m24h/esp2400/running/frontface-install1.jpg

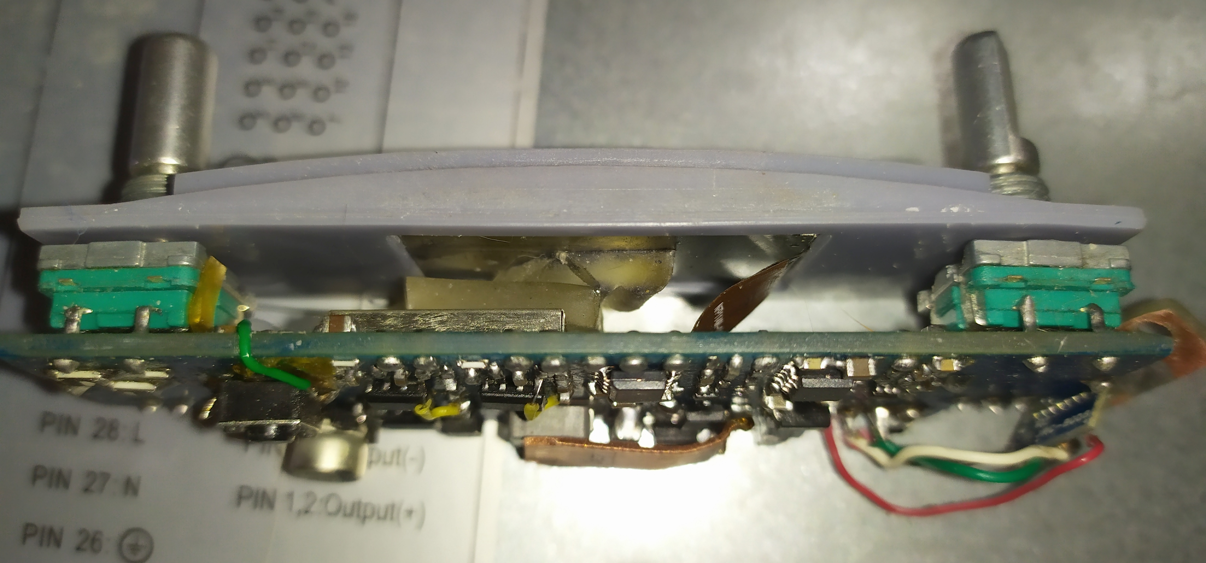
running/frontface-install1.jpg
