m24h/esp2400/hardware/discharge_output/discharge_pcb.png

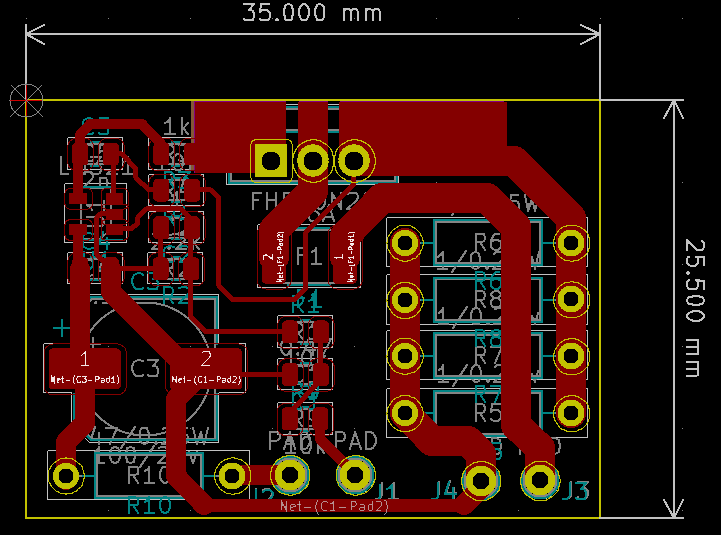
hardware/discharge_output/discharge_pcb.png
