m24h/esp2400/hardware/discharge_output/discharge_sch.png

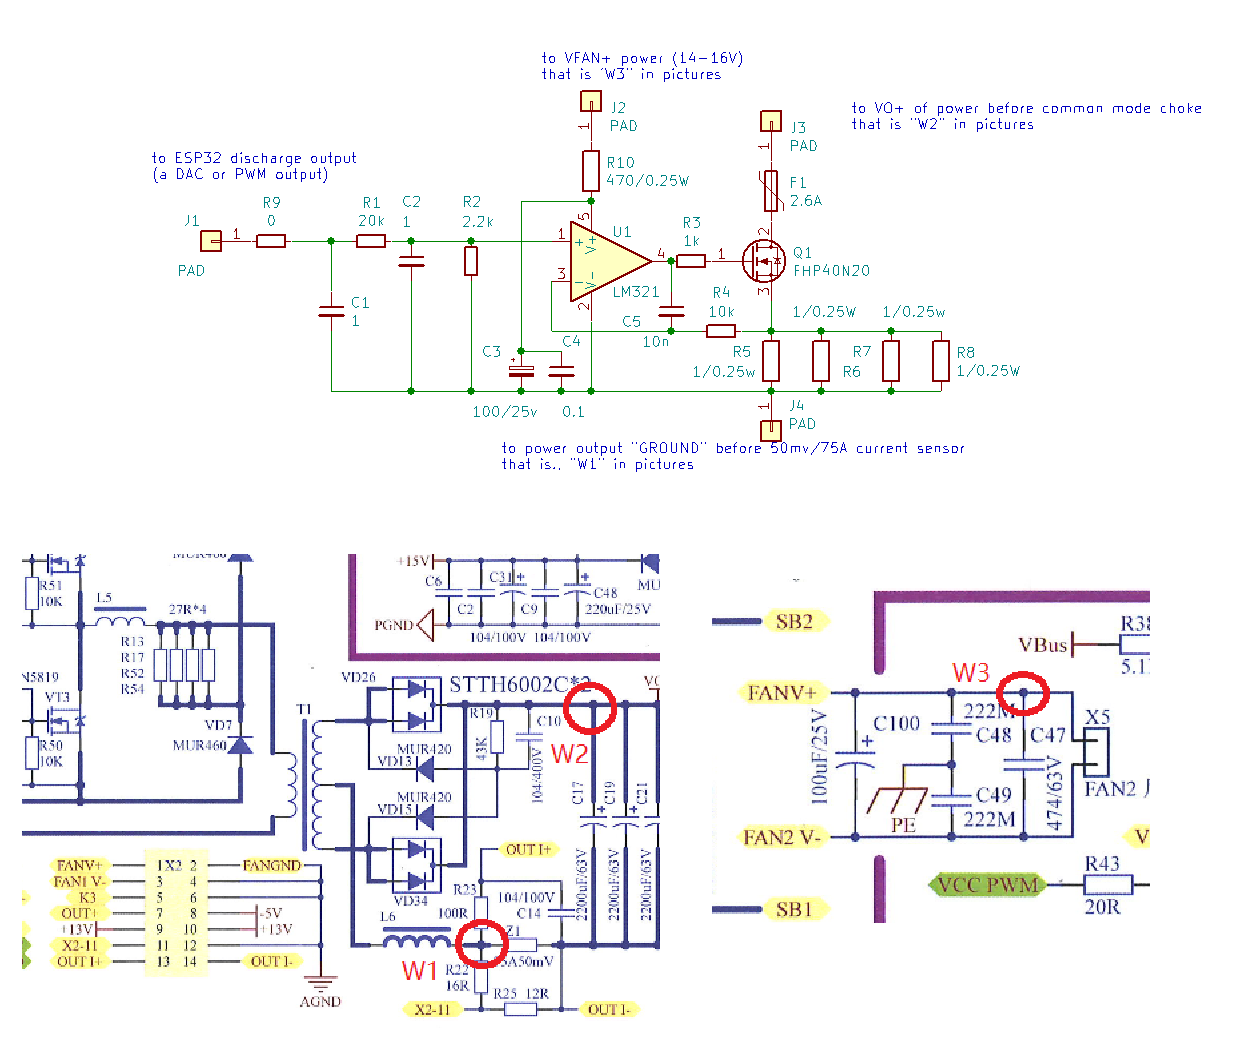
hardware/discharge_output/discharge_sch.png
