m24h/esp2400/hardware/esp2400_output/esp2400_pcb_B.png

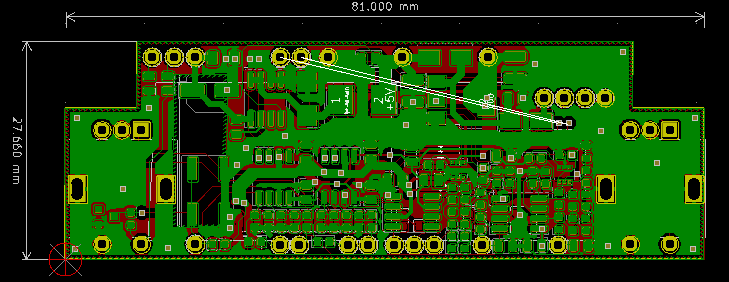
hardware/esp2400_output/esp2400_pcb_B.png
