m24h/esp2400/hardware/esp2400_output/esp2400_sch.png

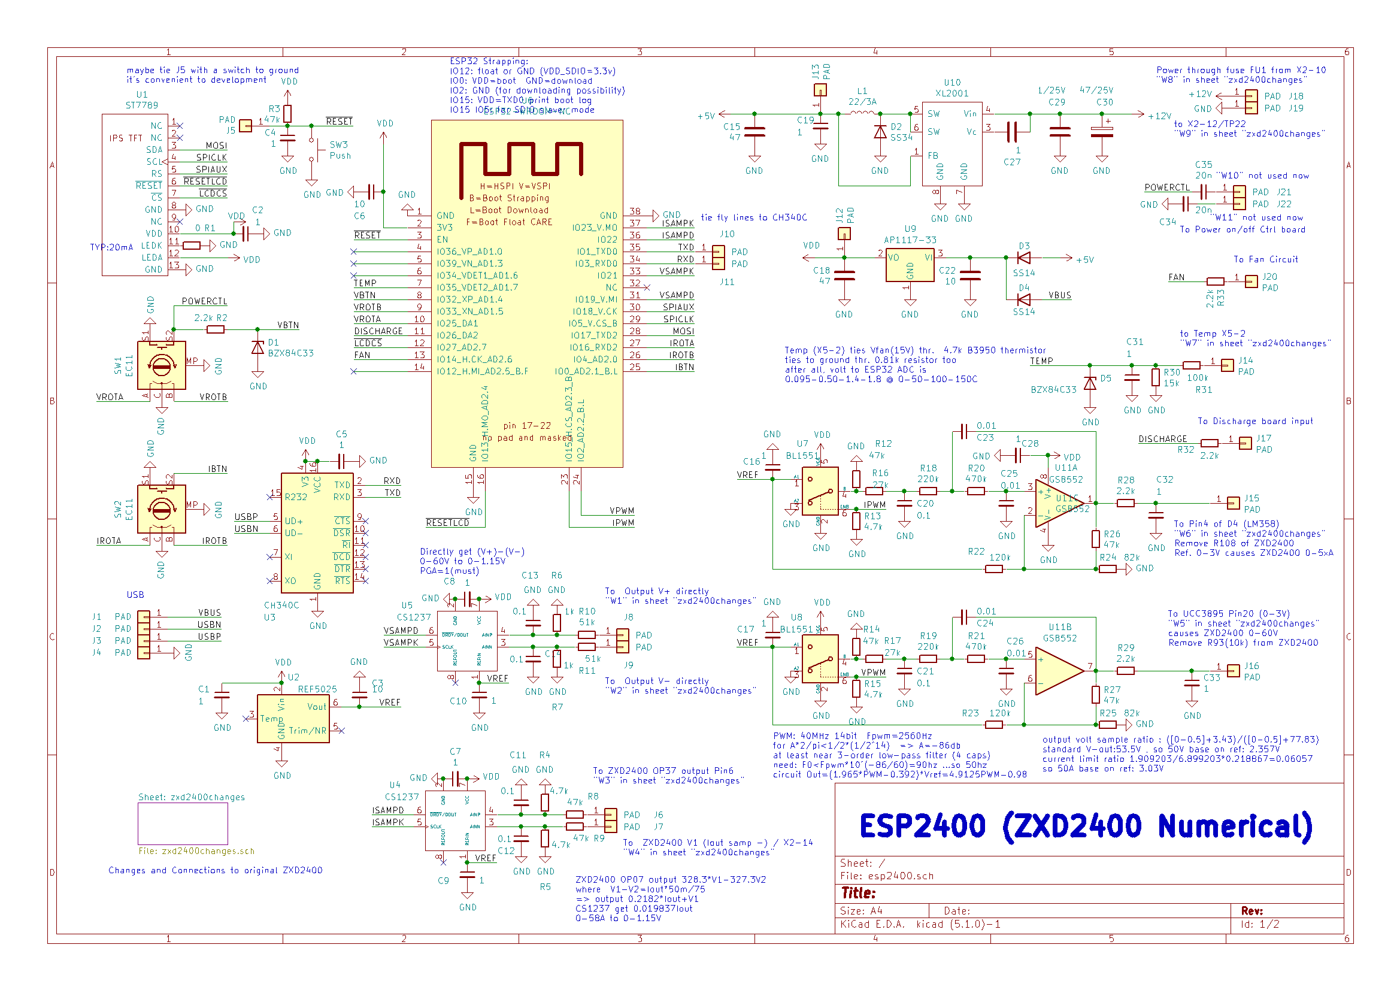
hardware/esp2400_output/esp2400_sch.png
