m24h/esp2400/hardware/fan_output/fan_pcb.png

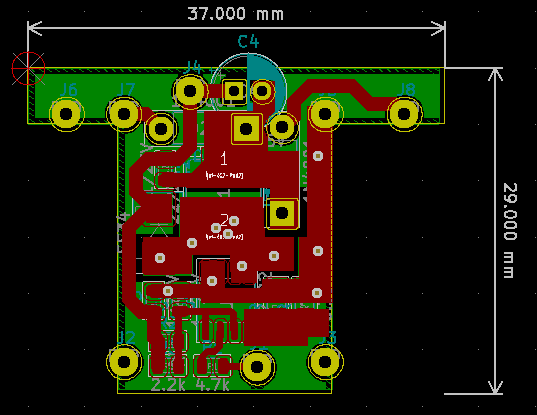
hardware/fan_output/fan_pcb.png
