m24h/esp2400/hardware/fan_output/fan_sch.png

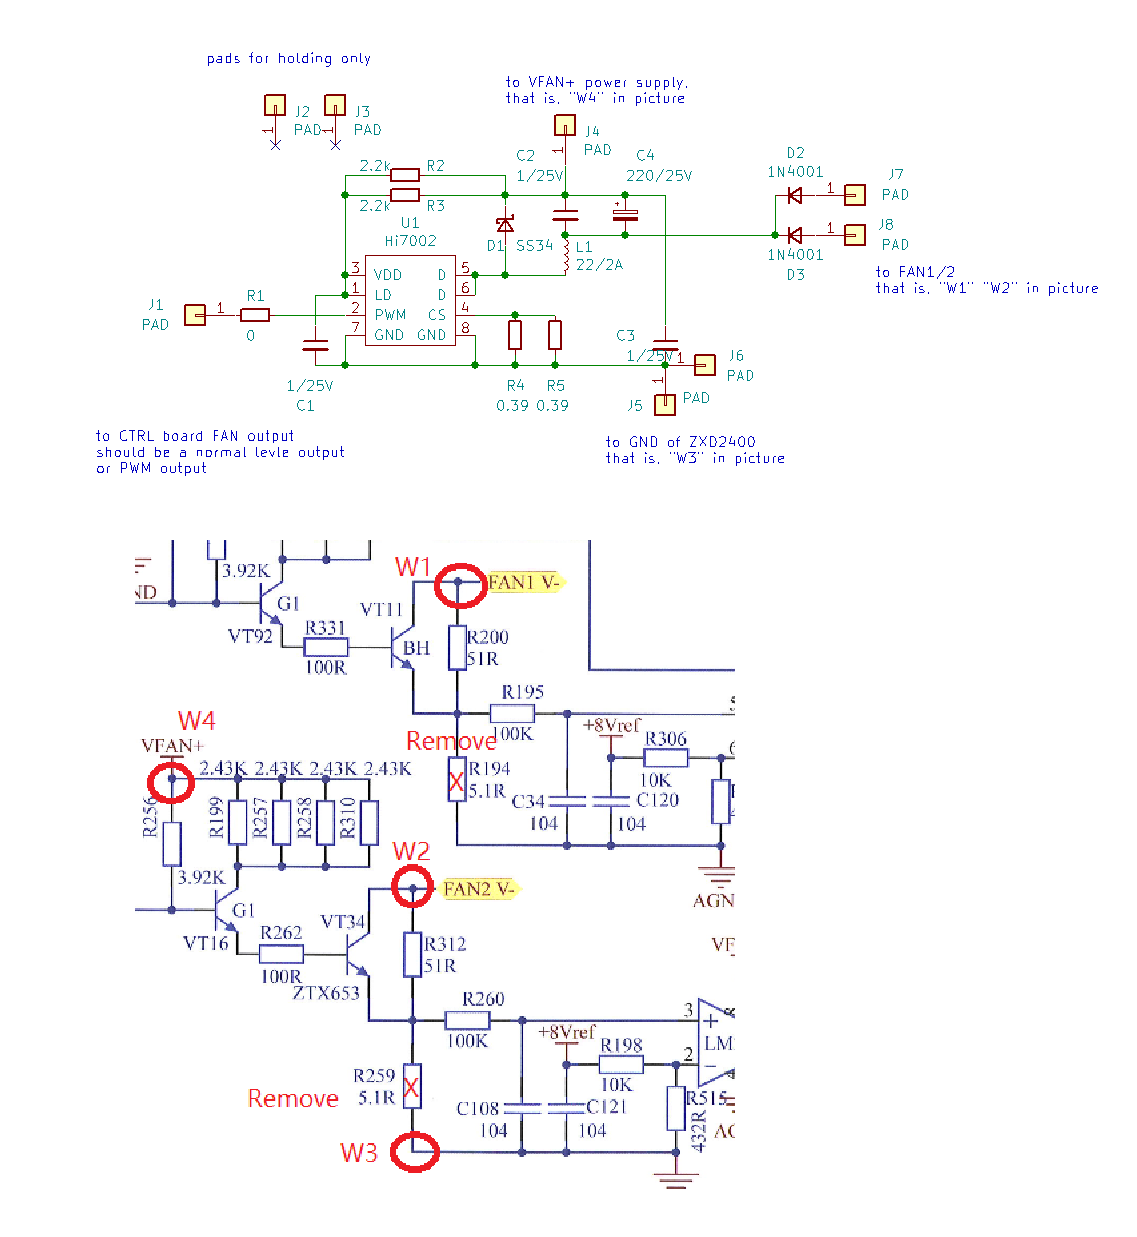
hardware/fan_output/fan_sch.png
