m24h/esp2400/running/discharge-connect.png

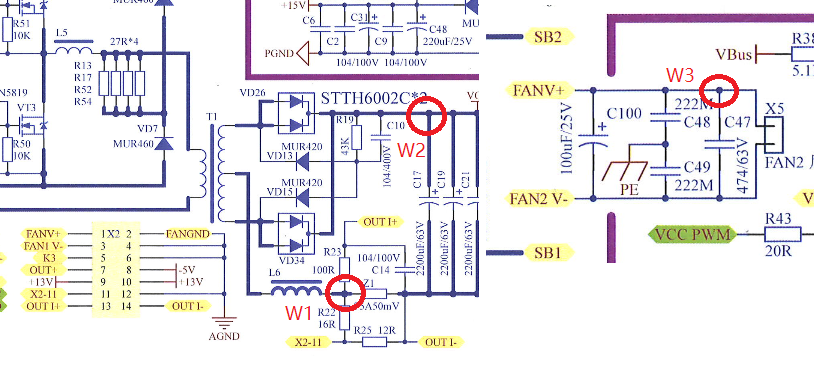
running/discharge-connect.png
