m24h/esp2400/running/drifting in 2 hours.jpg

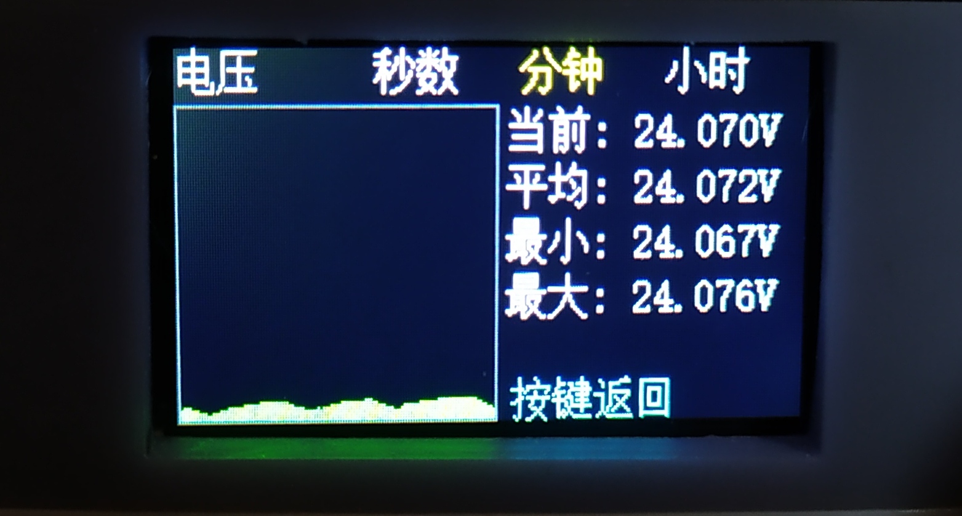
running/drifting in 2 hours.jpg
