m24h/esp2400/running/esp2400-connect.png

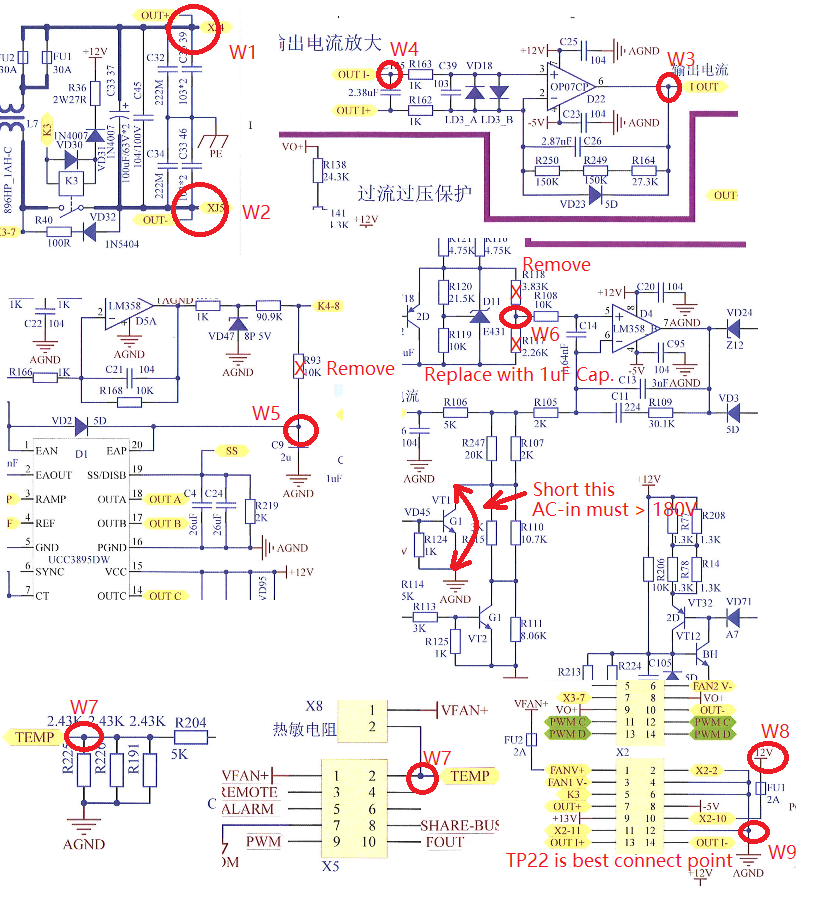
running/esp2400-connect.png
