m24h/esp2400/running/fan and discharge board.jpg

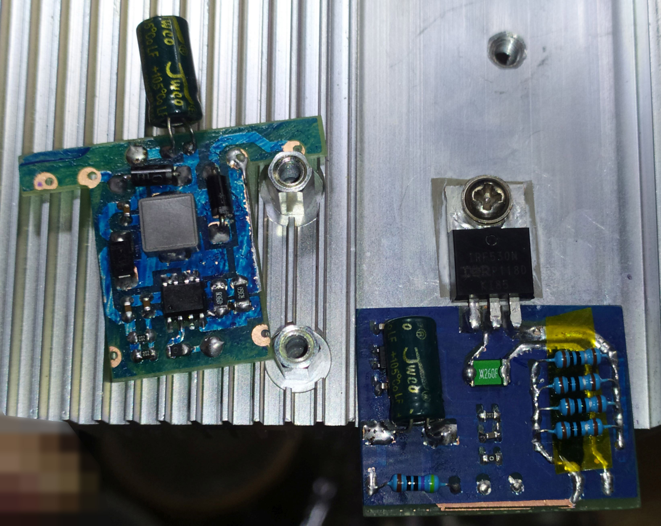
running/fan and discharge board.jpg
