m24h/esp2400/running/fan-connect.png

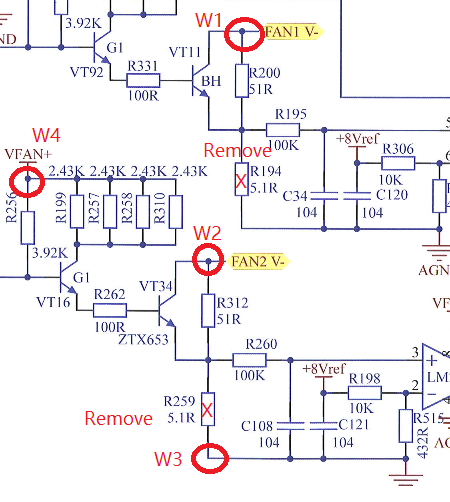
running/fan-connect.png
