m24h/esp2400/running/Mask NC Pin of ESP32.jpg

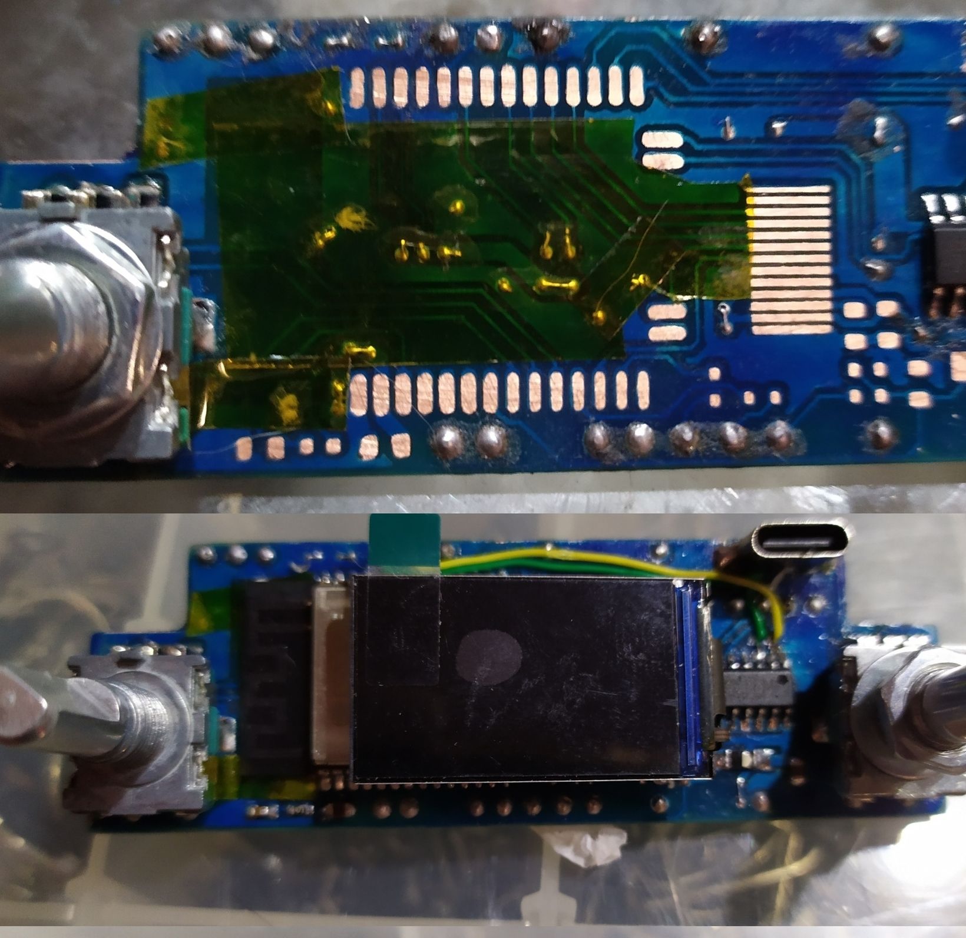
running/Mask NC Pin of ESP32.jpg
