m24h/esp2400/running/modify1.jpg

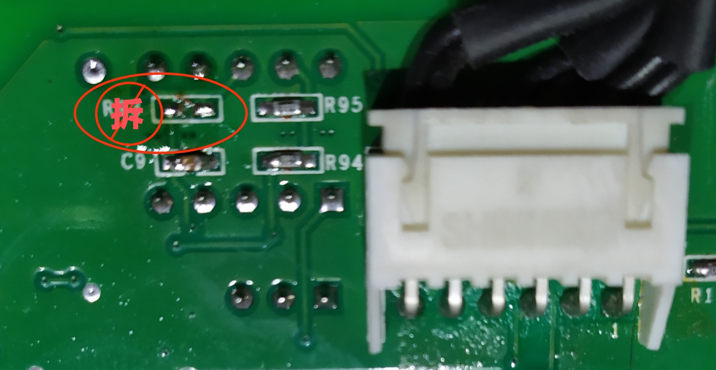
running/modify1.jpg
