m24h/esp2400/running/modify2.jpg

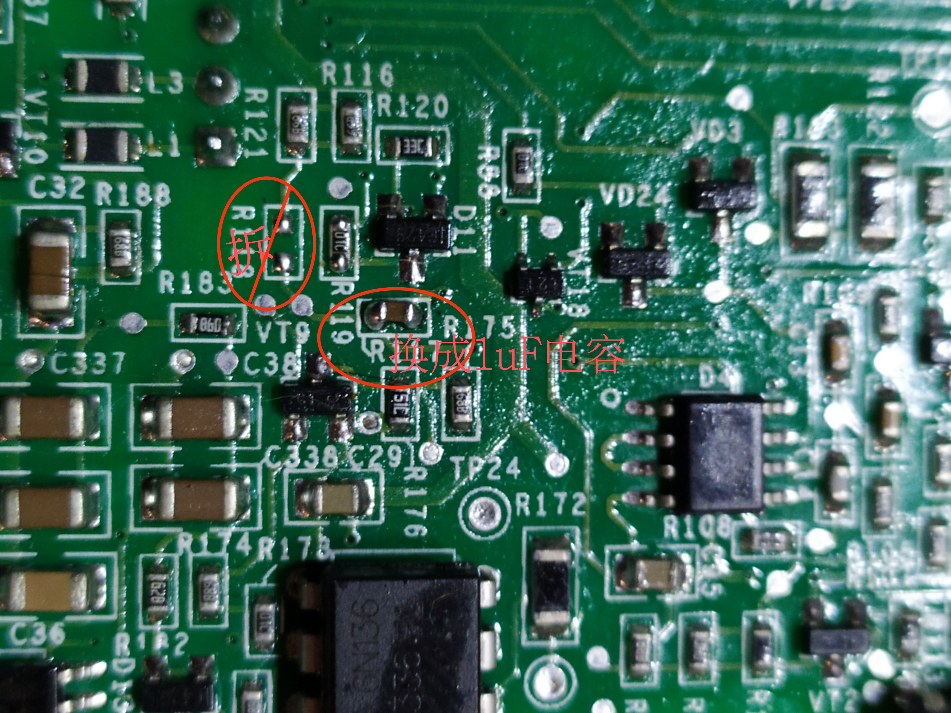
running/modify2.jpg
