m24h/esp2400/running/modify3.jpg

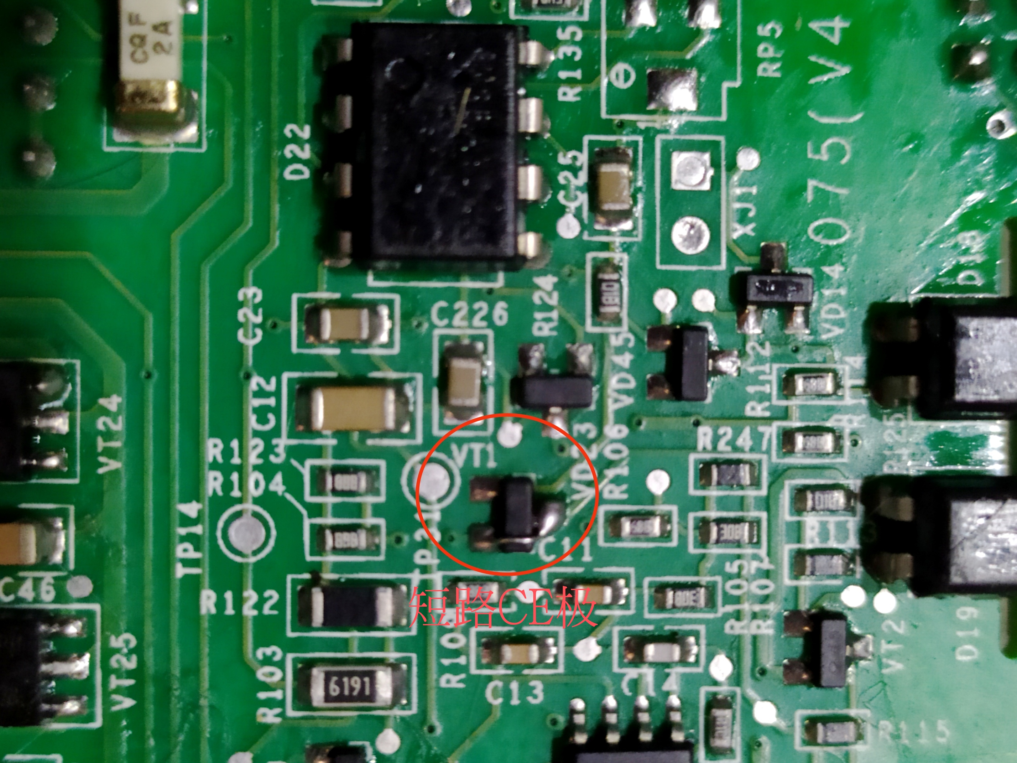
running/modify3.jpg
