m24h/esp2400/running/output 1.1V.jpg

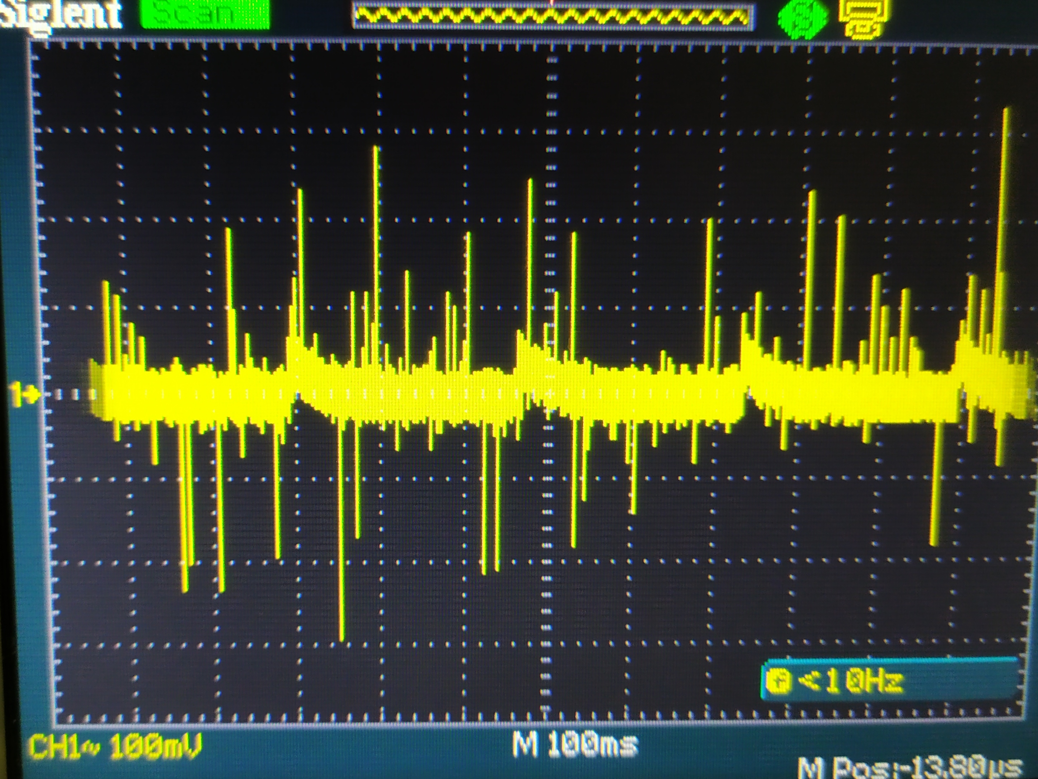
running/output 1.1V.jpg
