m24h/esp2400/running/output greater than 5V.jpg

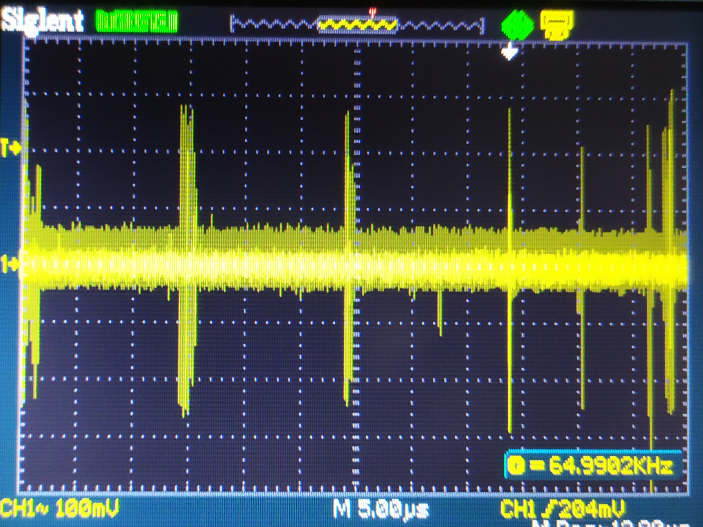
running/output greater than 5V.jpg
