m24h/esp2400/parts/backface.png

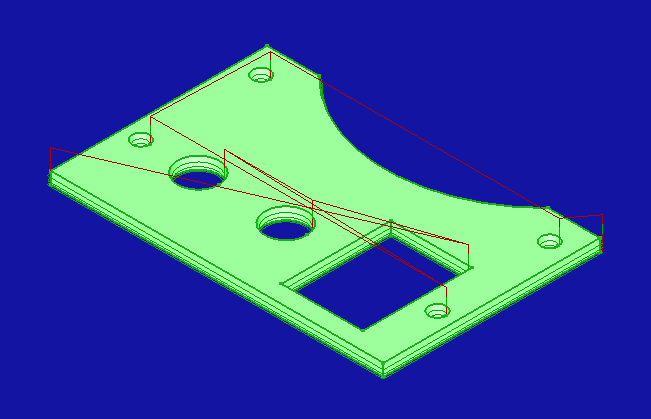
parts/backface.png
