m24h/esp2400/parts/face.png

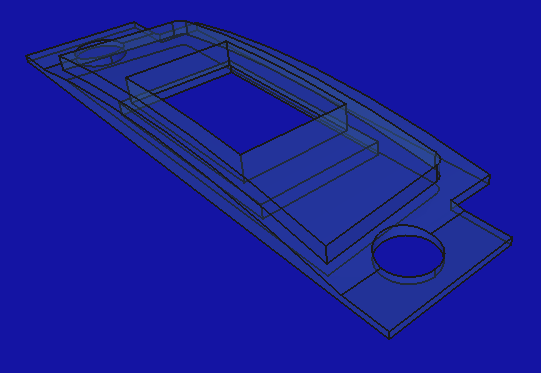
parts/face.png
