m24h/esp2400/parts/Mezzanine.png

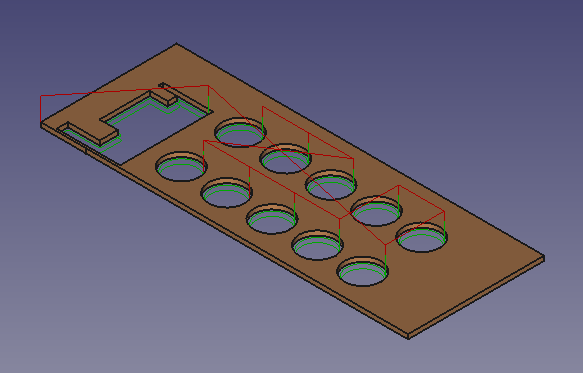
parts/Mezzanine.png
