m24h/esp2400/parts/face.FCStd

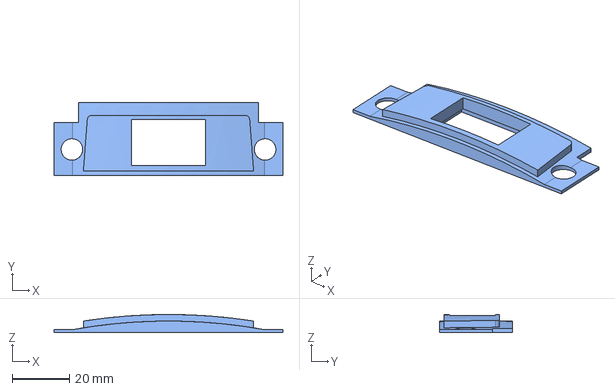
[picture p24: CAD file, 2022-01-13]
parts/face.FCStd
80.0 x 25.5 x 6.30 mm
