m24h/esp2400/parts/backface.FCStd

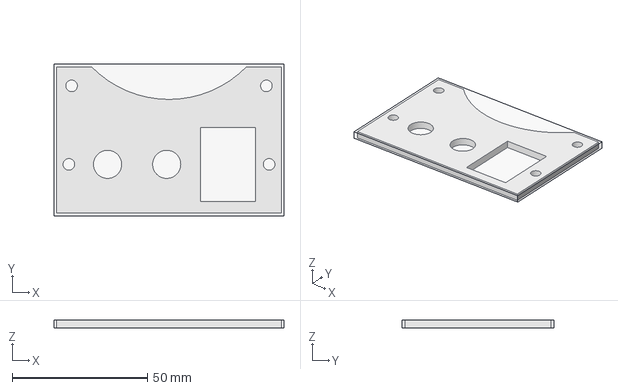
[picture p25: CAD file, 2022-01-13]
parts/backface.FCStd
85.0 x 56.0 x 3.00 mm
Model-Body
Stock
