m24h/esp2400/parts/Mezzanine.FCStd

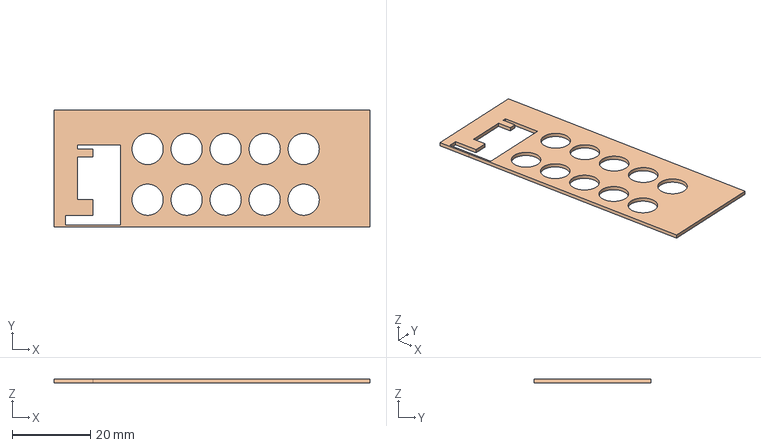
[picture p26: CAD file, 2022-01-13]
parts/Mezzanine.FCStd
81.0 x 30.0 x 1.00 mm
