m24h/esp2400/(list of files, cad)

Other CAD files:
parts/face.stl
