m24h/esp2400/running/backface-install2.jpg

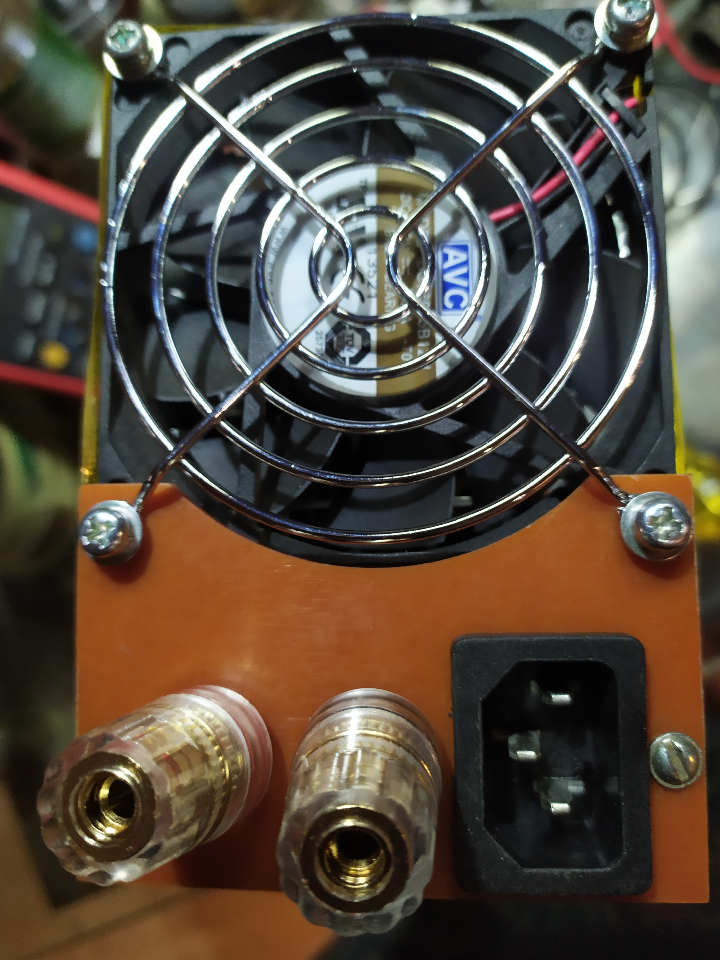
running/backface-install2.jpg
