m24h/esp2400/running/discharge-install.jpg

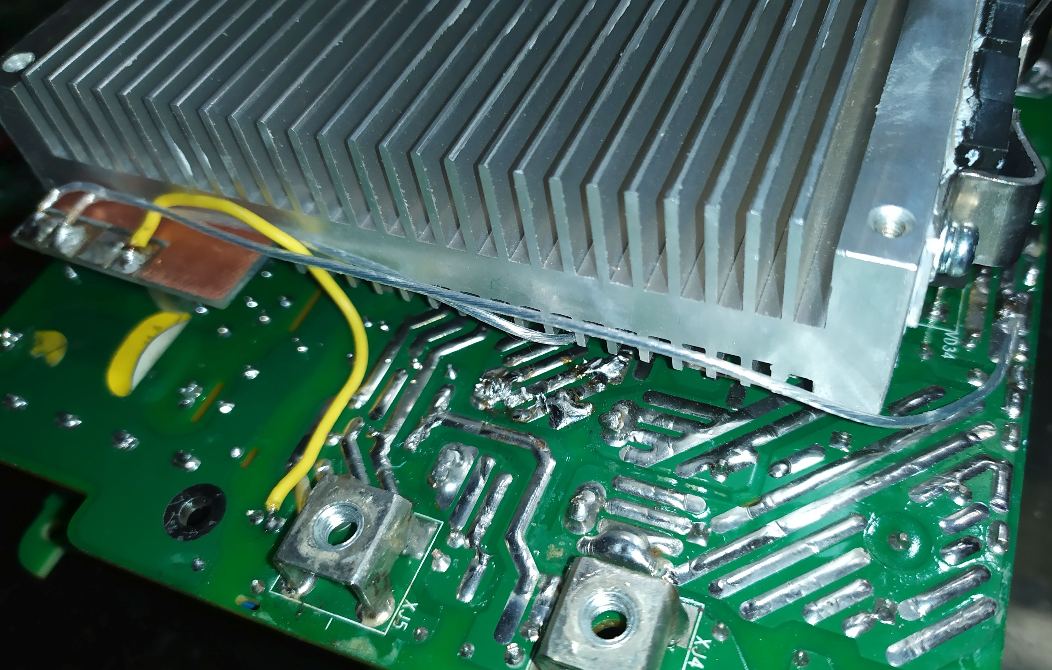
running/discharge-install.jpg
