m24h/esp2400/running/esp2400-install1.jpg

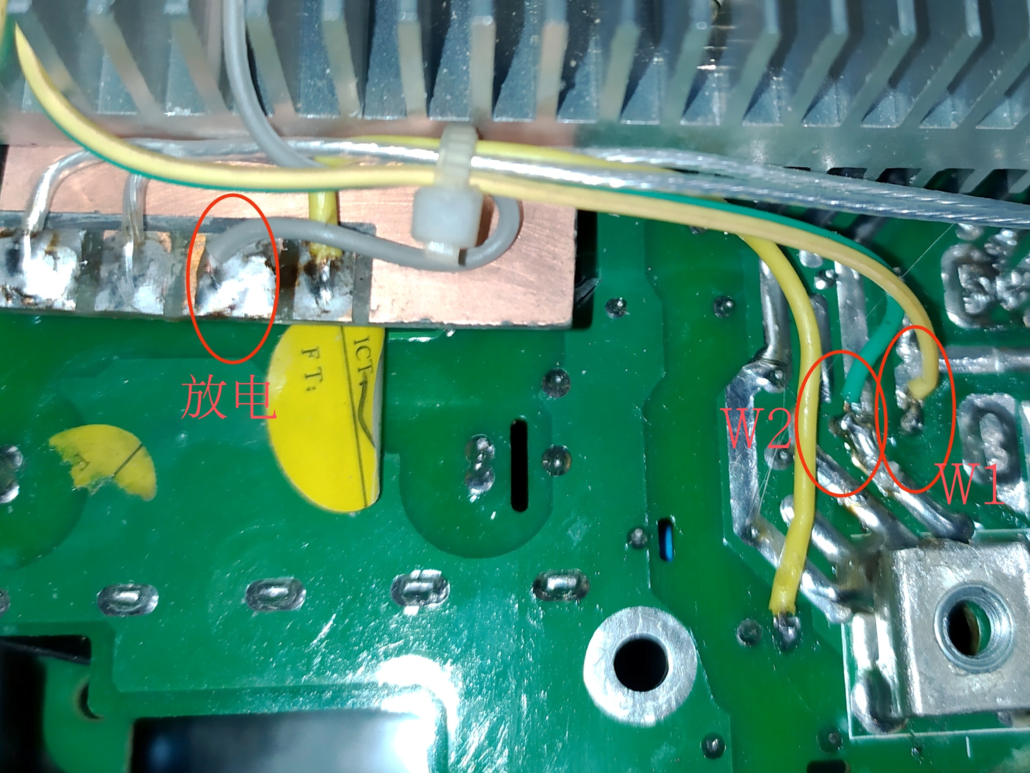
running/esp2400-install1.jpg
