m24h/esp2400/running/esp2400-install4.jpg

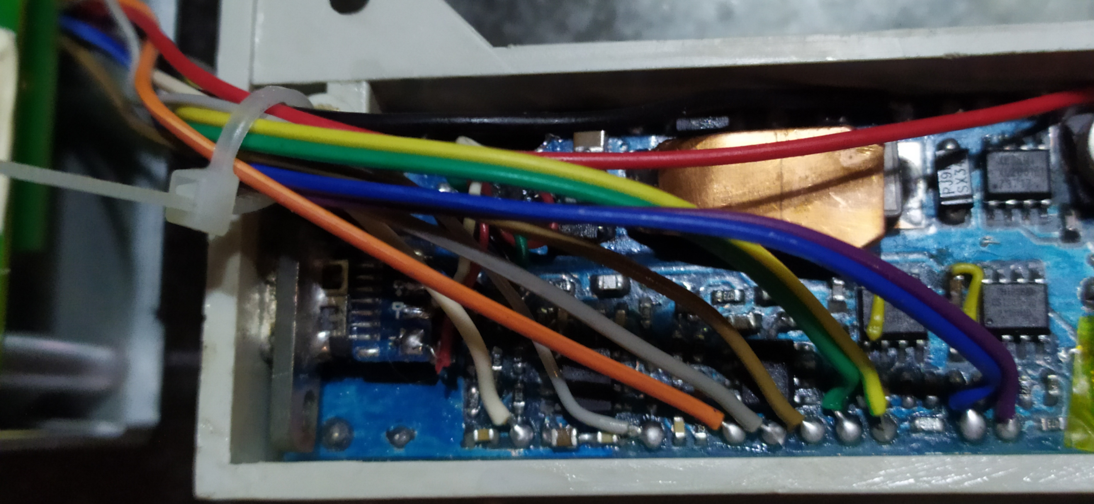
running/esp2400-install4.jpg
