m24h/esp2400/running/fan-install.jpg

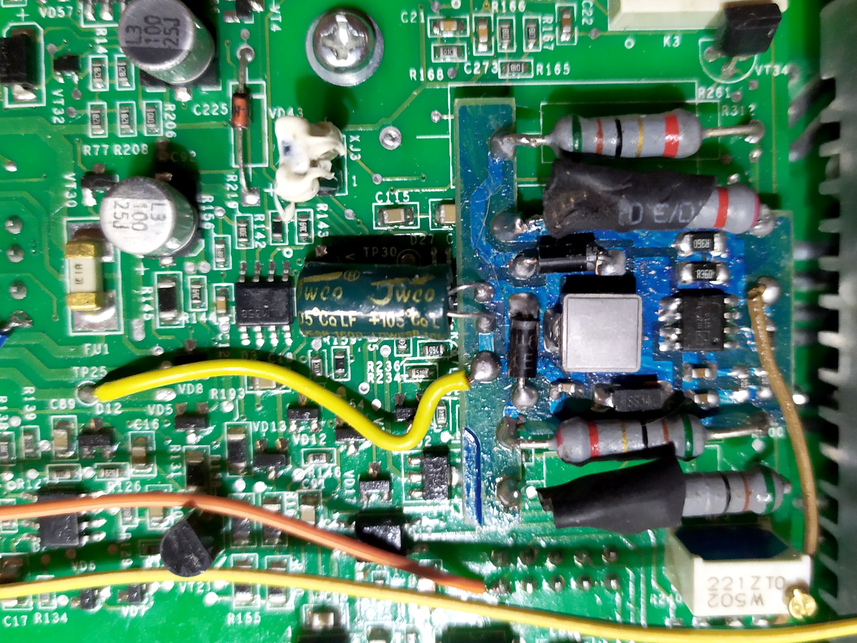
running/fan-install.jpg
