m24h/esp2400/running/frontface-install2.jpg

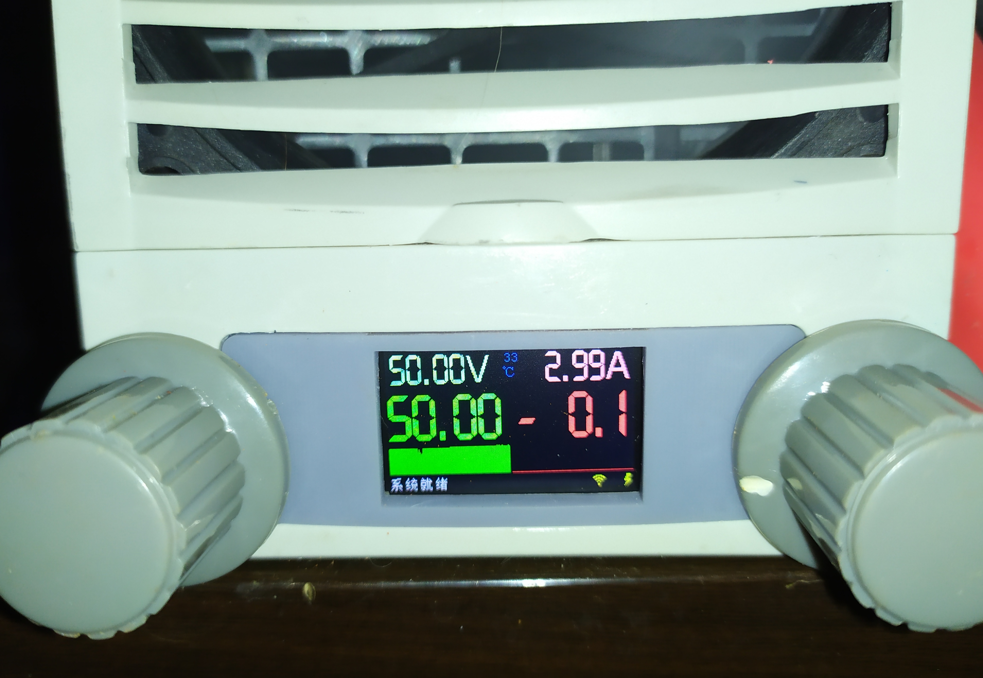
running/frontface-install2.jpg
