m24h/esp2400/running/mezzanine-install.jpg

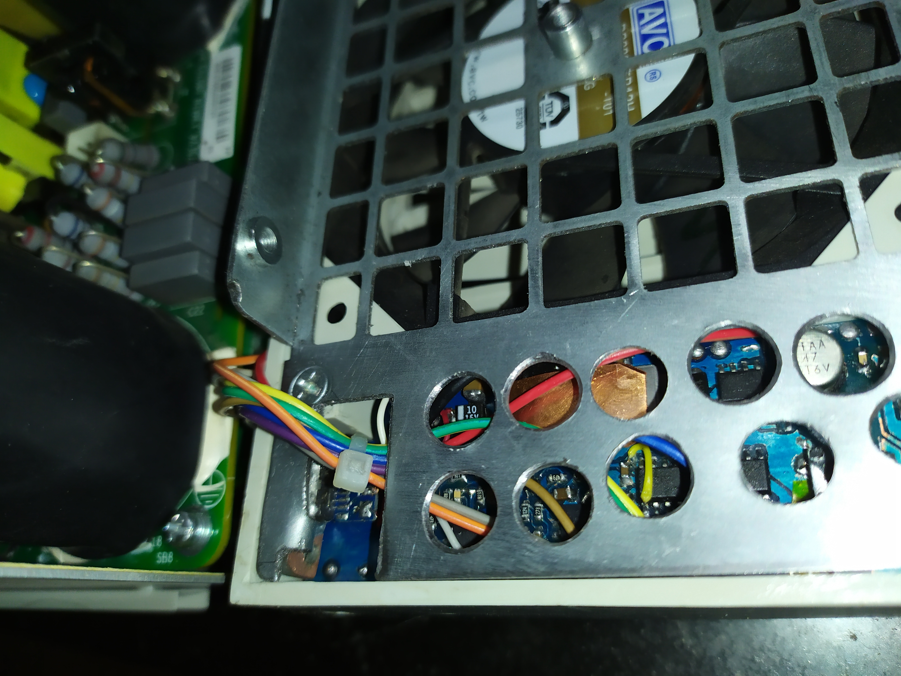
running/mezzanine-install.jpg
