m24h/esp2400/hardware/discharge_output/discharge-F_Cu.pdf

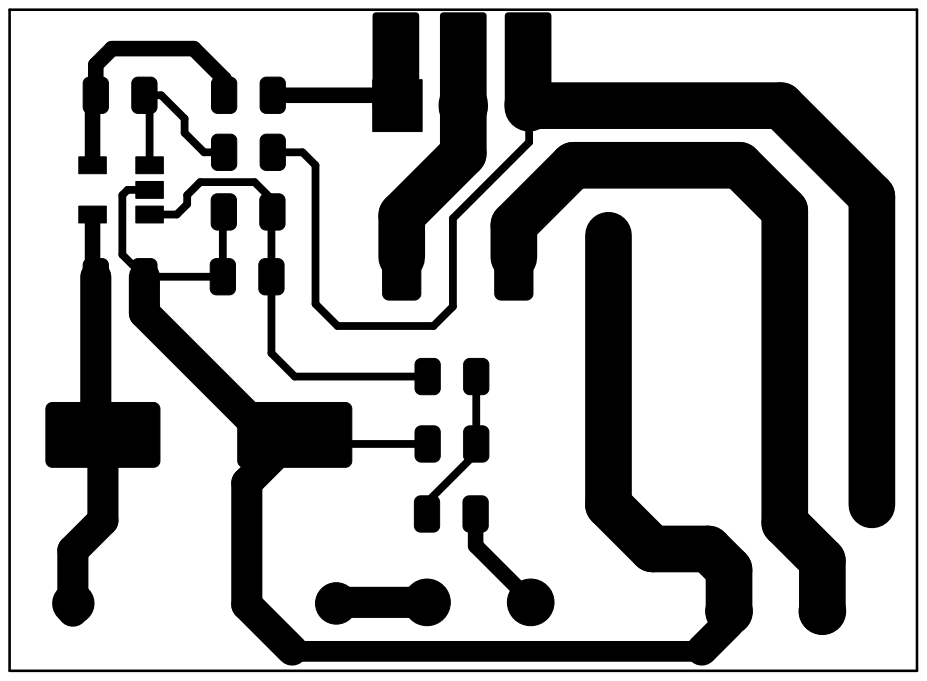
[picture p35: page 1]
