m24h/esp2400/hardware/discharge_output/discharge-F_Mask.pdf

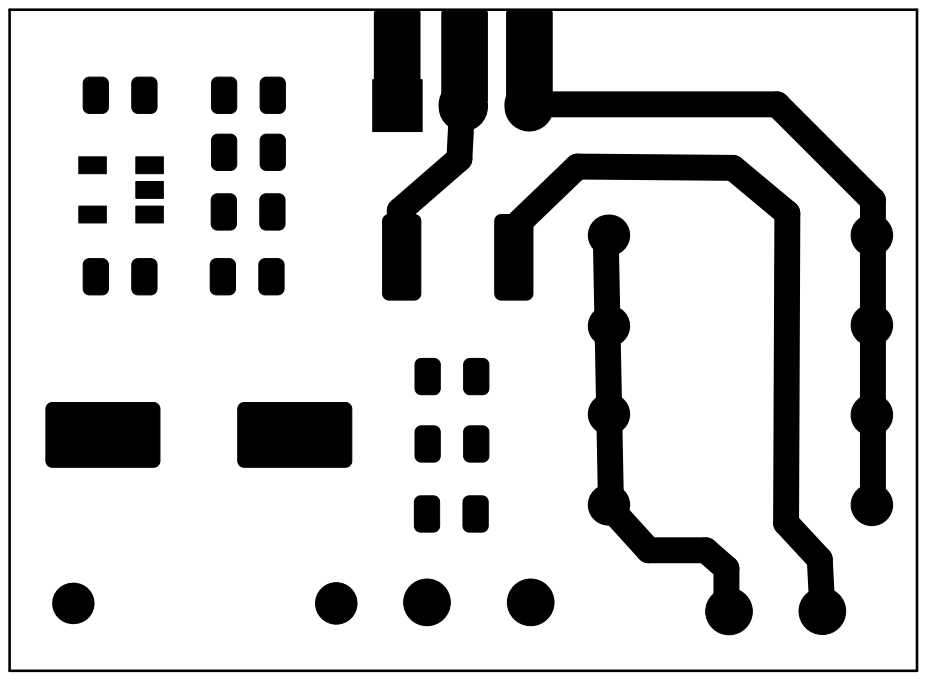
[picture p36: page 1]
