m24h/esp2400/hardware/esp2400_output/esp2400-B_Cu.pdf

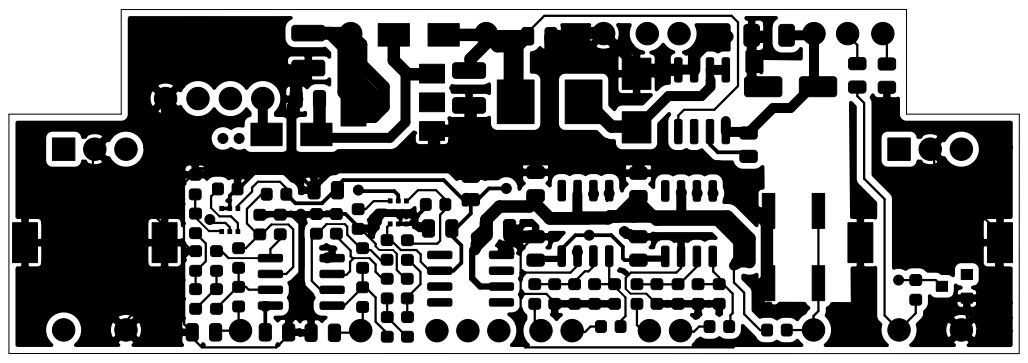
[picture p37: page 1]
