m24h/esp2400/hardware/esp2400_output/esp2400-B_Mask.pdf

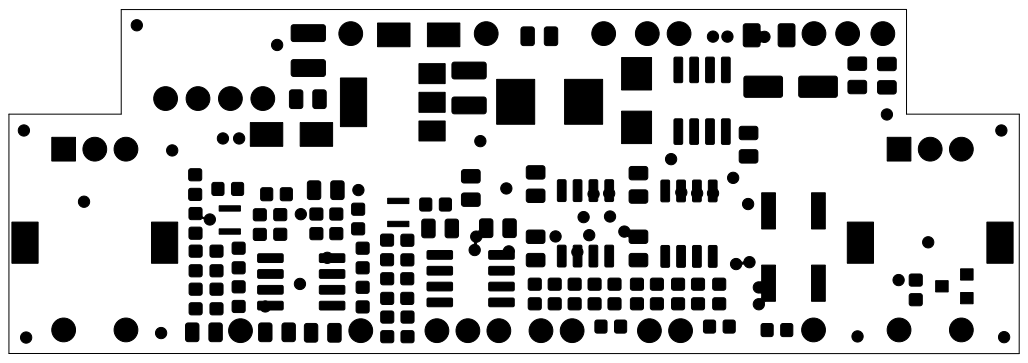
[picture p38: page 1]
