m24h/esp2400/hardware/esp2400_output/esp2400-F_Cu.pdf

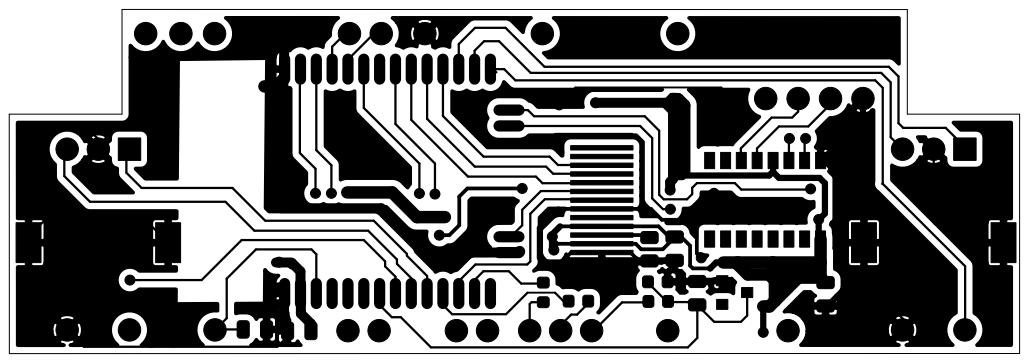
[picture p39: page 1]
