m24h/esp2400/hardware/esp2400_output/esp2400-F_Mask.pdf

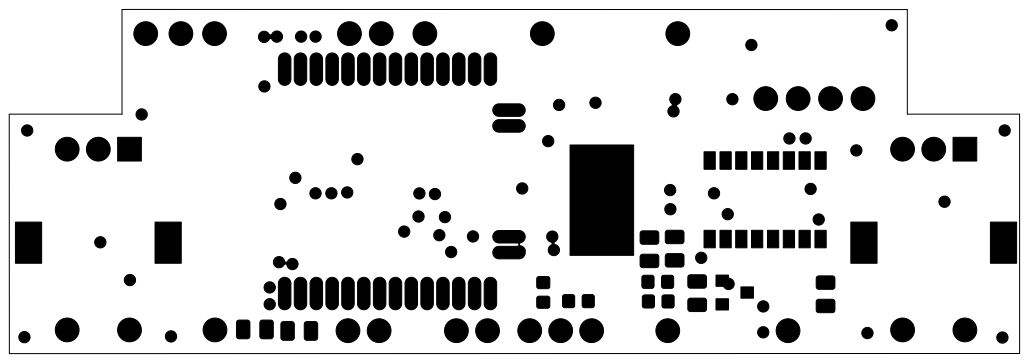
[picture p40: page 1]
