m24h/esp2400/hardware/fan_output/fan-B_Cu.pdf

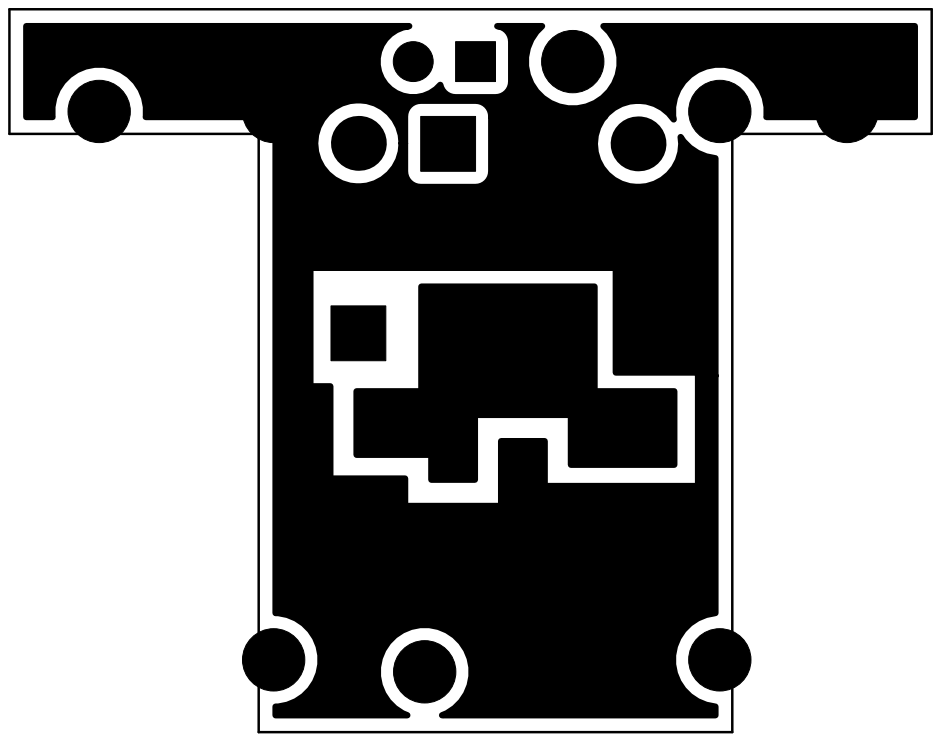
[picture p41: page 1]
