m24h/esp2400/hardware/fan_output/fan-B_Mask.pdf

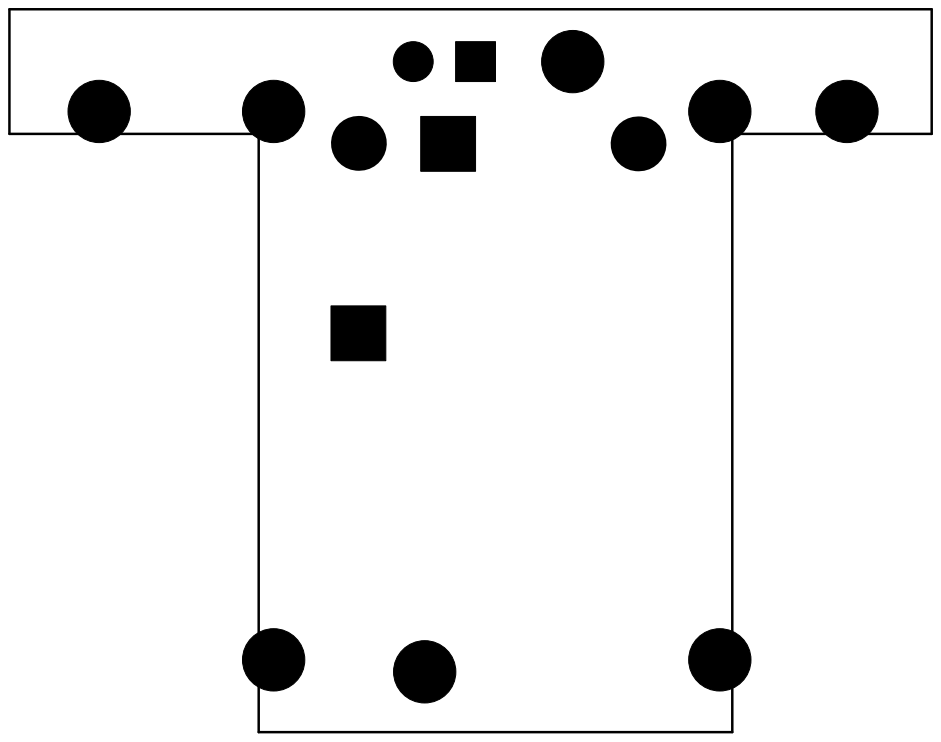
[picture p42: page 1]
