m24h/esp2400/hardware/fan_output/fan-F_Cu.pdf

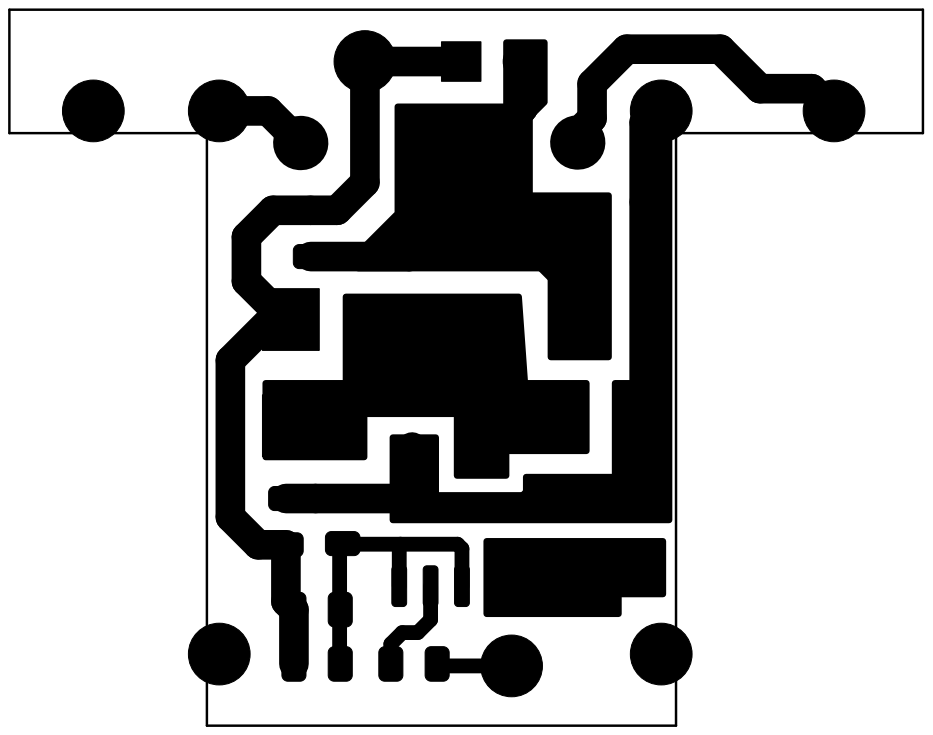
[picture p43: page 1]
