m24h/esp2400/hardware/fan_output/fan-F_Mask.pdf

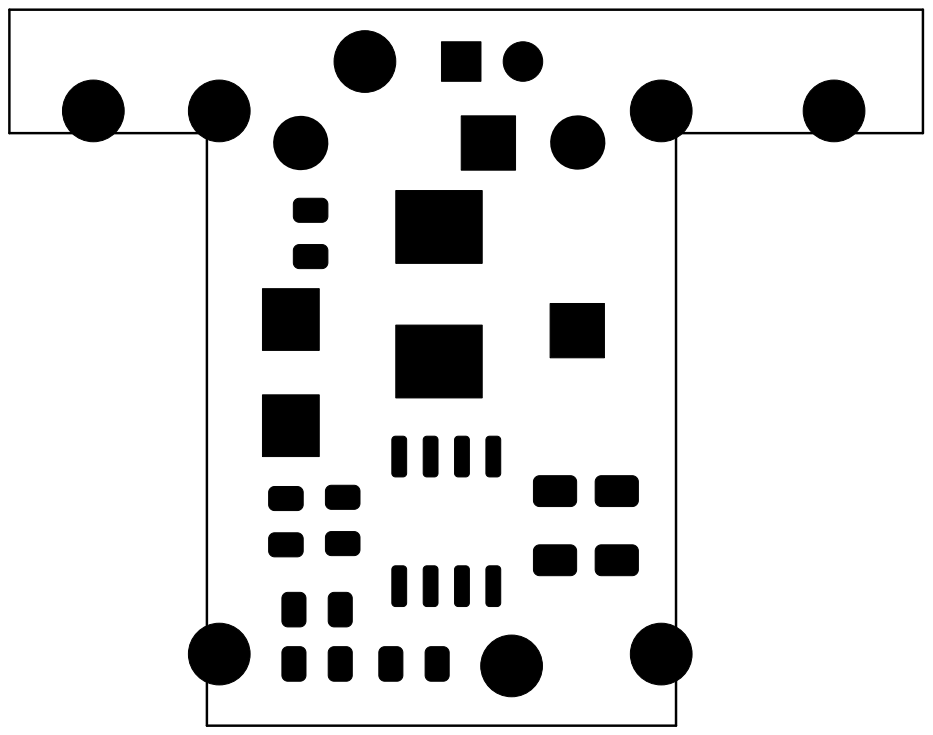
[picture p44: page 1]
