m24h/esp2400/hardware/discharge.kicad_pcb

## KiCad design hardware/discharge.kicad_pcb (2022-01-13)

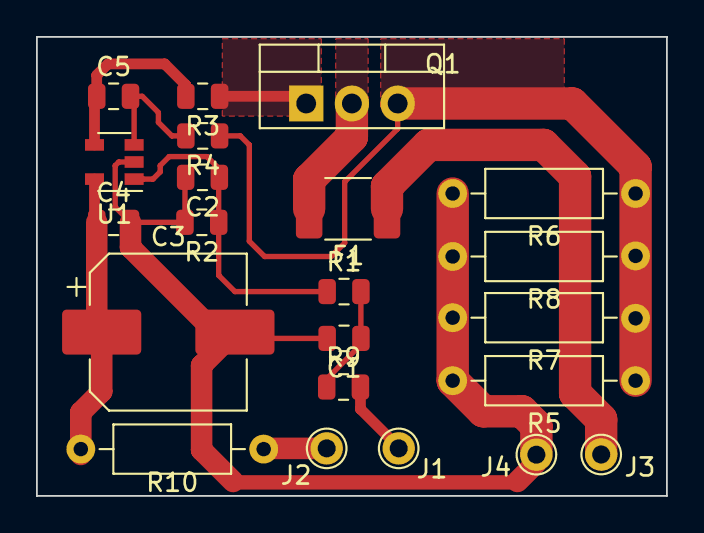
[picture p45: board discharge.kicad_pcb from above]

Board: 2 copper layers, 35.0 x 25.5 mm, 22 parts (0 on the bottom side), 12 nets.

Parts:
C1: 0.47; C_0805_2012Metric
C2: 1; C_0805_2012Metric
C3: 100/25v; CP_Elec_8x10.5
C4: 0.1; C_0805_2012Metric
C5: 2n; C_0805_2012Metric
F1: 2.6A; Fuse_1812_4532Metric_Castellated
J1, J2, J3, J4: PAD; Pad
Q1: FHP40N20; TO-220-3_Vertical
R1, R4, R9: 10k; R_0805_2012Metric
R2: 2.2k; R_0805_2012Metric
R3: 1k; R_0805_2012Metric
R5, R7: 1/0.25w; R_Axial_DIN0207_L6.3mm_D2.5mm_P10.16mm_Horizontal
R6, R8: 1/0.25W; R_Axial_DIN0207_L6.3mm_D2.5mm_P10.16mm_Horizontal
R10: 47/0.25W; R_Axial_DIN0207_L6.3mm_D2.5mm_P10.16mm_Horizontal
U1: LM321; SOT-23-5

Connections:
unnamed: C1.1, R1.2, R9.1
unnamed: C1.2, C2.2, C3.2, C4.2, J4.1, R2.2, R5.2, R6.2, R7.2, R8.2, U1.2
unnamed: C2.1, R1.1, R2.1, U1.1
unnamed: C3.1, C4.1, R10.2, U1.5
unnamed: C5.1, R3.2, U1.4
unnamed: C5.2, R4.2, U1.3
unnamed: F1.1, J3.1
unnamed: F1.2, Q1.2
unnamed: J1.1, R9.2
unnamed: J2.1, R10.1
unnamed: Q1.1, R3.1
unnamed: Q1.3, R4.1, R5.1, R6.1, R7.1, R8.1
