m24h/esp2400/hardware/esp2400.kicad_pcb

## KiCad design hardware/esp2400.kicad_pcb (2022-01-13)

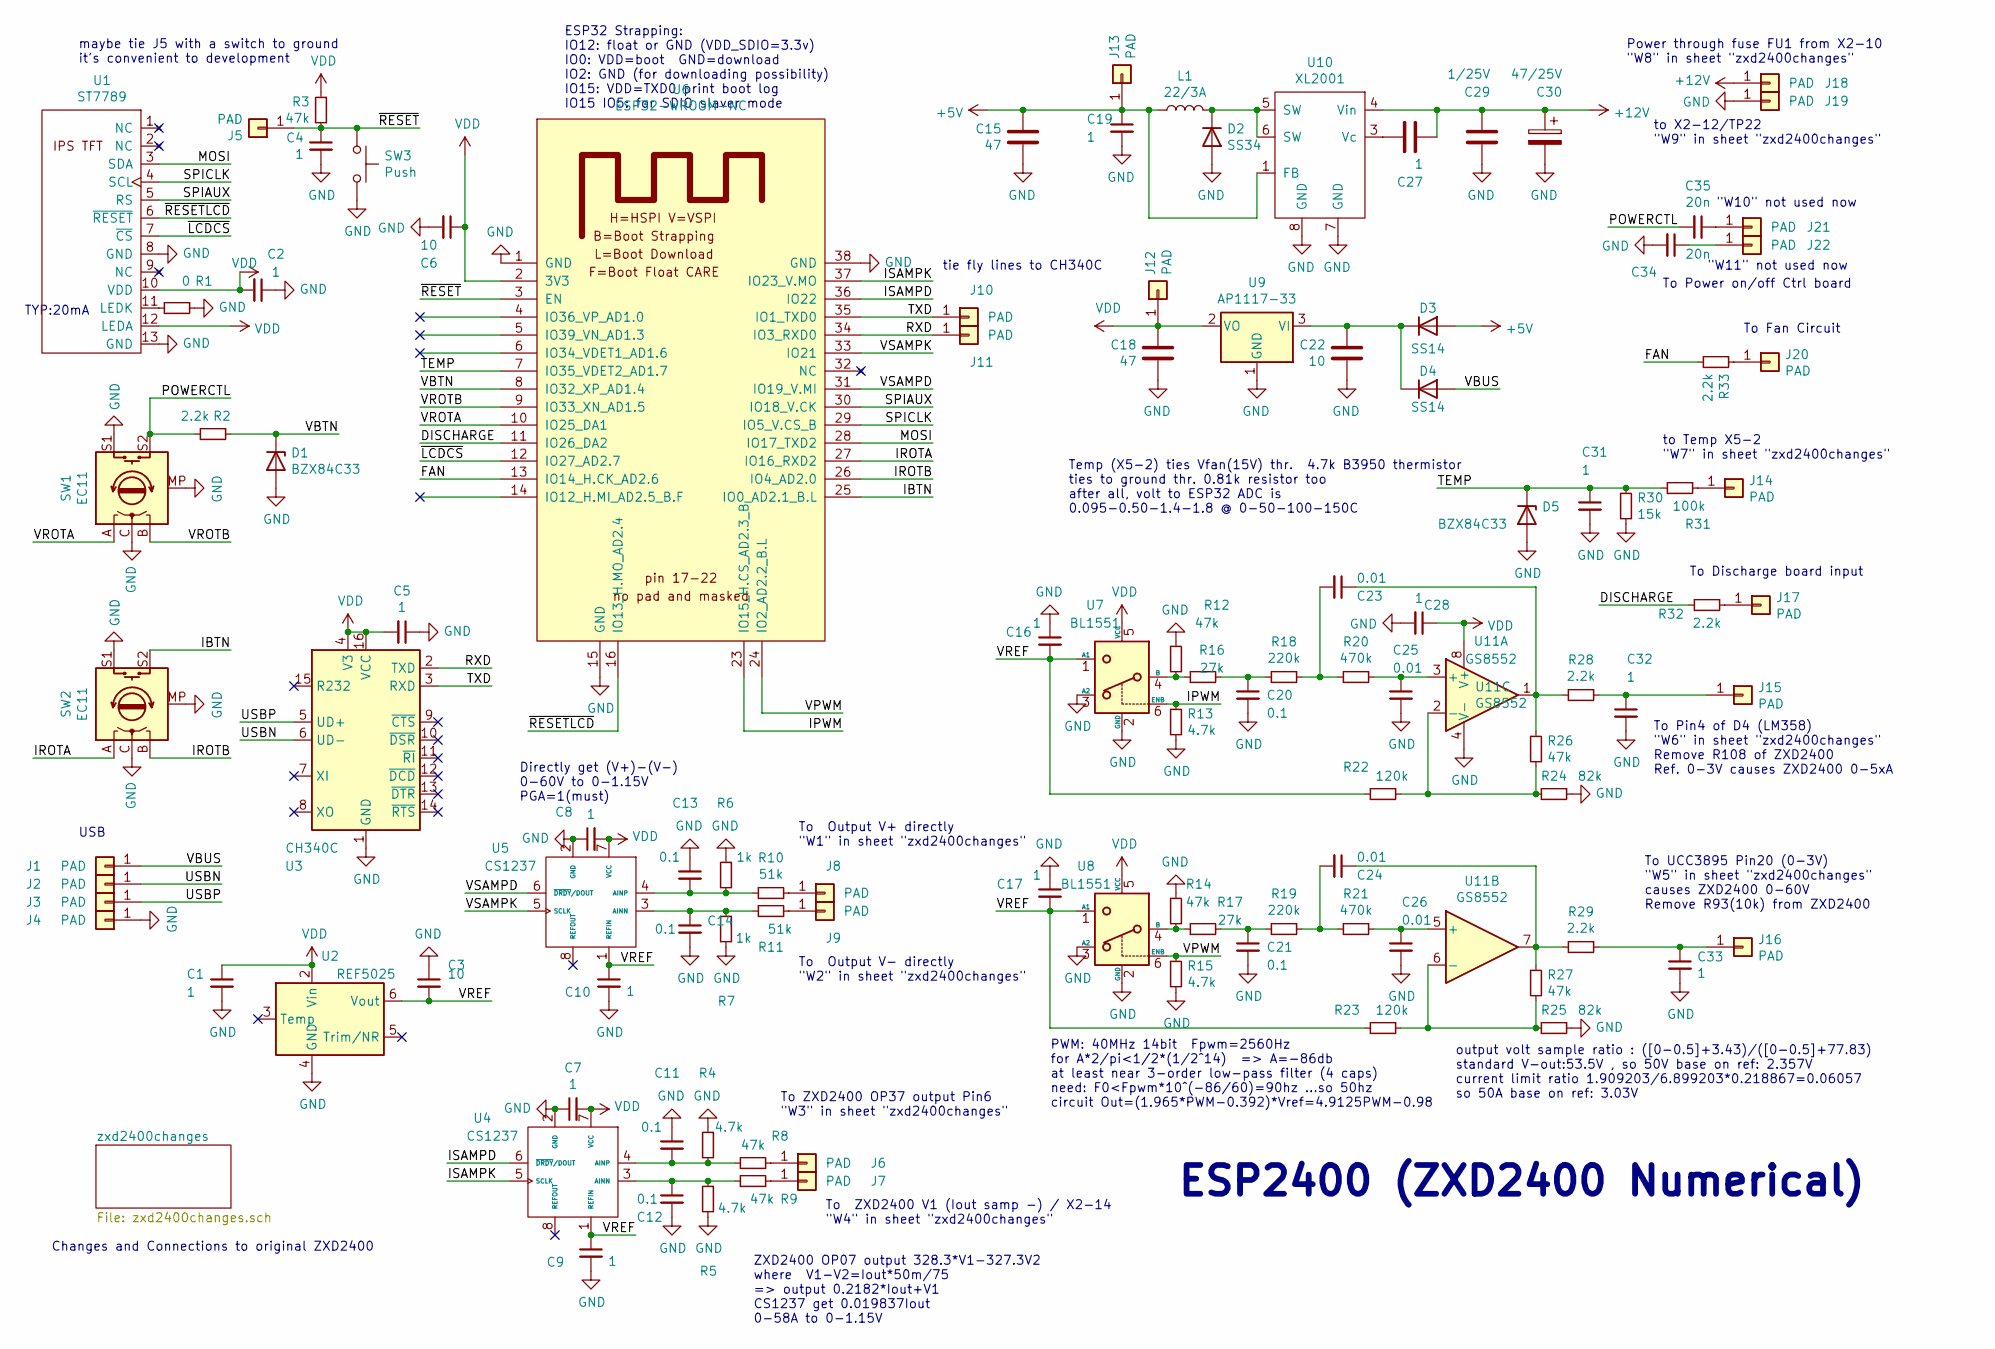
[picture p46: schematic esp2400.sch]

Parts:
C1, C2, C4, C5, C7, C8, C9, C10, C16, C17, C19, C27, C28, C31, C32, C33: 1; C_0805_2012Metric
C3, C6, C22: 10; C_0805_2012Metric
C11, C12, C13, C14, C20, C21: 0.1; C_0603_1608Metric
C15, C18: 47; C_1210_3225Metric
C23, C24, C25, C26: 0.01; C_0603_1608Metric
C29: 1/25V; C_1206_3216Metric
C30: 47/25V; CP_Elec_5x5.9
C34, C35: 20n; C_0805_2012Metric
D1, D5: BZX84C33; D_SOT-23_ANK
D2: SS34; D_SMB
D3, D4: SS14; D_SMA
J1, J2, J3, J4, J5, J6, J7, J8, J9, J10, J11, J12, J13, J14, J15, J16, J17, J18, J19, J20, J21, J22: PAD; Pad
L1: 22/3A; L_Bourns_SRP7028A_7.3x6.6mm
R1: 0; R_0805_2012Metric
R2, R28, R29, R32, R33: 2.2k; R_0603_1608Metric
R3, R8, R9, R12, R14, R26, R27: 47k; R_0603_1608Metric
R4, R5, R13, R15: 4.7k; R_0603_1608Metric
R6, R7: 1k; R_0603_1608Metric
R10, R11: 51k; R_0603_1608Metric
R16, R17: 27k; R_0603_1608Metric
R18, R19: 220k; R_0603_1608Metric
R20, R21: 470k; R_0603_1608Metric
R22, R23: 120k; R_0603_1608Metric
R24, R25: 82k; R_0603_1608Metric
R30: 15k; R_0603_1608Metric
R31: 100k; R_0603_1608Metric
SW1, SW2: EC11; RotaryEncoder_Alps_EC11E-Switch_Vertical_H20mm
SW3: Push; SW_Push_1P1T_NO_CK_KSC6xxJ
U1: ST7789; 1.14LCD
U2: REF5025; SOIC-8_3.9x4.9mm_P1.27mm
U3: CH340C; SOP-16_4.4x10.4mm_P1.27mm
U4, U5: CS1237; SOP-8_3.9x4.9mm_P1.27mm
U6: ESP32-WROOM-NC
U7, U8: BL1551; SC70-6
U9: AP1117-33; SOT-223-3_TabPin2
U10: XL2001; SOIC-8_3.9x4.9mm_P1.27mm
U11: GS8552; SOIC-8_3.9x4.9mm_P1.27mm

Connections:
+5V: C15.1, C19.1, D3.2 (A), J13.1, L1.2, U10.1 (FB)
+12V: C27.2, C29.1, C30.1, J18.1, U10.4 (Vin)
/DISCHARGE: R32.2, U6.11 (IO26_DA2)
/FAN: R33.2, U6.13 (IO14_H.CK_AD2.6)
/IBTN: SW2.S2, U6.25 (IO0_AD2.1_B.L)
/IPWM: R13.1, U6.23 (IO15_H.CS_AD2.3_B), U7.6 (ENB)
/IROTA: SW2.A, U6.27 (IO16_RXD2)
/IROTB: SW2.B, U6.26 (IO4_AD2.0)
/ISAMPD: U4.6 (~DRDY~/DOUT), U6.36 (IO22)
/ISAMPK: U4.5 (SCLK), U6.37 (IO23_V.MO)
/MOSI: U1.3 (SDA), U6.28 (IO17_TXD2)
/POWERCTL: C35.2, R2.2, SW1.S2
/RXD: J11.1, U3.2 (TXD), U6.34 (IO3_RXD0)
/SPIAUX: U1.5 (RS), U6.30 (IO18_V.CK)
/SPICLK: U1.4 (SCL), U6.29 (IO5_V.CS_B)
/TEMP: C31.1, D5.1 (K), R30.1, R31.2, U6.7 (IO35_VDET2_AD1.7)
/TXD: J10.1, U3.3 (RXD), U6.35 (IO1_TXD0)
/USBN: J2.1, U3.6 (UD-)
/USBP: J3.1, U3.5 (UD+)
/VBTN: D1.1 (K), R2.1, U6.8 (IO32_XP_AD1.4)
/VBUS: D4.2 (A), J1.1
/VPWM: R15.1, U6.24 (IO2_AD2.2_B.L), U8.6 (ENB)
/VREF: C3.2, C9.1, C10.1, C16.2, C17.2, R22.2, R23.2, U2.6 (Vout), U4.1 (REFIN), U5.1 (REFIN), U7.1 (A1), U8.1 (A1)
/VROTA: SW1.A, U6.10 (IO25_DA1)
/VROTB: SW1.B, U6.9 (IO33_XN_AD1.5)
/VSAMPD: U5.6 (~DRDY~/DOUT), U6.31 (IO19_V.MI)
/VSAMPK: U5.5 (SCLK), U6.33 (IO21)
/~LCDCS: U1.7 (~CS), U6.12 (IO27_AD2.7)
/~RESET: C4.1, J5.1, R3.2, SW3.1, U6.3 (EN)
/~RESETLCD: U1.6 (~RESET), U6.16 (IO13_H.MO_AD2.4)
GND: C1.2, C2.1, C3.1, C4.2, C5.1, C6.2, C7.1, C8.1, C9.2, C10.2, C11.1, C12.2, C13.1, C14.2, C15.2, C16.1, C17.1, C18.2, C19.2, C20.2, C21.2, C22.2, C25.2, C26.2, C28.2, C29.2, C30.2, C31.2, C32.2, C33.2, C34.2, D1.2 (A), D2.2 (A), D5.2 (A), J4.1, J19.1, R1.1, R4.1, R5.2, R6.1, R7.2, R12.1, R13.2, R14.1, R15.2, R24.1, R25.1, R30.2, SW1.C, SW1.MP, SW1.S1, SW2.C, SW2.MP, SW2.S1, SW3.2, U1.8 (GND), U1.13 (GND), U2.4 (GND), U3.1 (GND), U4.2 (GND), U5.2 (GND), U6.1 (GND), U6.15 (GND), U6.38 (GND), U7.2 (GND), U7.3 (A2), U8.2 (GND), U8.3 (A2), U9.1 (GND), U10.7 (GND), U10.8 (GND), U11.4 (V-)
unnamed: C11.2, R4.2, R8.2, U4.4 (AINP)
unnamed: C12.1, R5.1, R9.2, U4.3 (AINN)
unnamed: C13.2, R6.2, R10.2, U5.4 (AINP)
unnamed: C14.1, R7.1, R11.2, U5.3 (AINN)
unnamed: C20.1, R16.2, R18.2
unnamed: C21.1, R17.2, R19.2
unnamed: C22.1, D3.1 (K), D4.1 (K), U9.3 (VI)
unnamed: C23.1, R26.1, R28.2, U11.1
unnamed: C23.2, R18.1, R20.2
unnamed: C24.1, R27.1, R29.2, U11.7
unnamed: C24.2, R19.1, R21.2
unnamed: C25.1, R20.1, U11.3 (+)
unnamed: C26.1, R21.1, U11.5 (+)
unnamed: C27.1, U10.3 (Vc)
unnamed: C32.1, J15.1, R28.1
unnamed: C33.1, J16.1, R29.1
unnamed: C34.1, J22.1
unnamed: C35.1, J21.1
unnamed: D2.1 (K), L1.1, U10.5 (SW), U10.6 (SW)
unnamed: J6.1, R8.1
unnamed: J7.1, R9.1
unnamed: J8.1, R10.1
unnamed: J9.1, R11.1
unnamed: J14.1, R31.1
unnamed: J17.1, R32.1
unnamed: J20.1, R33.1
unnamed: R1.2, U1.11 (LEDK)
unnamed: R12.2, R16.1, U7.4 (B)
unnamed: R14.2, R17.1, U8.4 (B)
unnamed: R22.1, R24.2, R26.2, U11.2 (-)
unnamed: R23.1, R25.2, R27.2, U11.6 (-)
VDD: C1.1, C2.2, C5.2, C6.1, C7.2, C8.2, C18.1, C28.1, J12.1, R3.1, U1.10 (VDD), U1.12 (LEDA), U2.2 (Vin), U3.4 (V3), U3.16 (VCC), U4.7 (VCC), U5.7 (VCC), U6.2 (3V3), U7.5 (VCC), U8.5 (VCC), U9.2 (VO), U11.8 (V+)

Notes on the sheet:
TYP:20mA
Power through fuse FU1 from X2-10 "W8" in sheet "zxd2400changes"
To Fan Circuit
to X2-12/TP22 "W9" in sheet "zxd2400changes"
To Discharge board input
To UCC3895 Pin20 (0-3V) "W5" in sheet "zxd2400changes" causes ZXD2400 0-60V Remove R93(10k) from ZXD2400
ESP32 Strapping: IO12: float or GND (VDD_SDIO=3.3v) IO0: VDD=boot GND=download IO2: GND (for downloading possibility) IO15: VDD=TXD0 print boot log IO15 IO5: for SDIO slaver mode
PWM: 40MHz 14bit Fpwm=2560Hz for A*2/pi<1/2*(1/2^14) => A=-86db at least near 3-order low-pass filter (4 caps) need: F0<Fpwm*10^(-86/60)=90hz ...so 50hz circuit Out=(1.965*PWM-0.392)*Vref=4.9125PWM-0.98
To Output V+ directly "W1" in sheet "zxd2400changes"
To Output V- directly "W2" in sheet "zxd2400changes"
To ZXD2400 OP37 output Pin6 "W3" in sheet "zxd2400changes"
To ZXD2400 V1 (Iout samp -) / X2-14 "W4" in sheet "zxd2400changes"
Directly get (V+)-(V-) 0-60V to 0-1.15V PGA=1(must)
ZXD2400 OP07 output 328.3*V1-327.3V2 where V1-V2=Iout*50m/75 => output 0.2182*Iout+V1 CS1237 get 0.019837Iout 0-58A to 0-1.15V
To Power on/off Ctrl board
ESP2400 (ZXD2400 Numerical)
to Temp X5-2 "W7" in sheet "zxd2400changes"
To Pin4 of D4 (LM358) "W6" in sheet "zxd2400changes" Remove R108 of ZXD2400 Ref. 0-3V causes ZXD2400 0-5xA
USB
Temp (X5-2) ties Vfan(15V) thr. 4.7k B3950 thermistor ties to ground thr. 0.81k resistor too after all, volt to ESP32 ADC is 0.095-0.50-1.4-1.8 @ 0-50-100-150C
output volt sample ratio : ([0-0.5]+3.43)/([0-0.5]+77.83) standard V-out:53.5V , so 50V base on ref: 2.357V current limit ratio 1.909203/6.899203*0.218867=0.06057 so 50A base on ref: 3.03V
Changes and Connections to original ZXD2400
maybe tie J5 with a switch to ground it's convenient to development
tie fly lines to CH340C
"W10" not used now
"W11" not used now

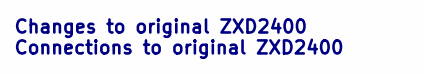
[picture p47: schematic zxd2400changes.sch]

Notes on the sheet:
Changes to original ZXD2400 Connections to original ZXD2400

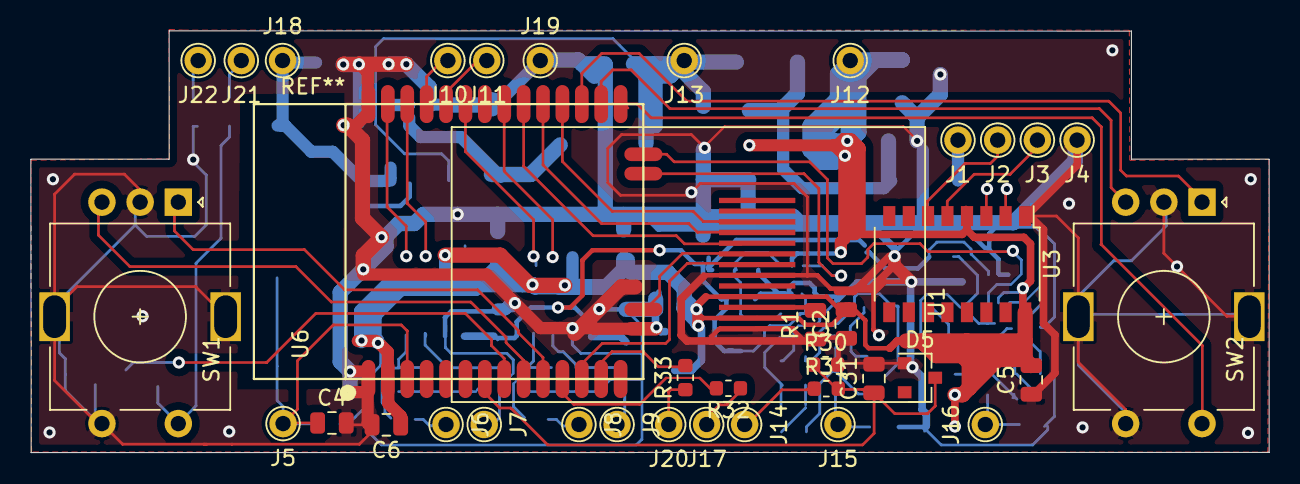
[picture p48: board esp2400.kicad_pcb from above]

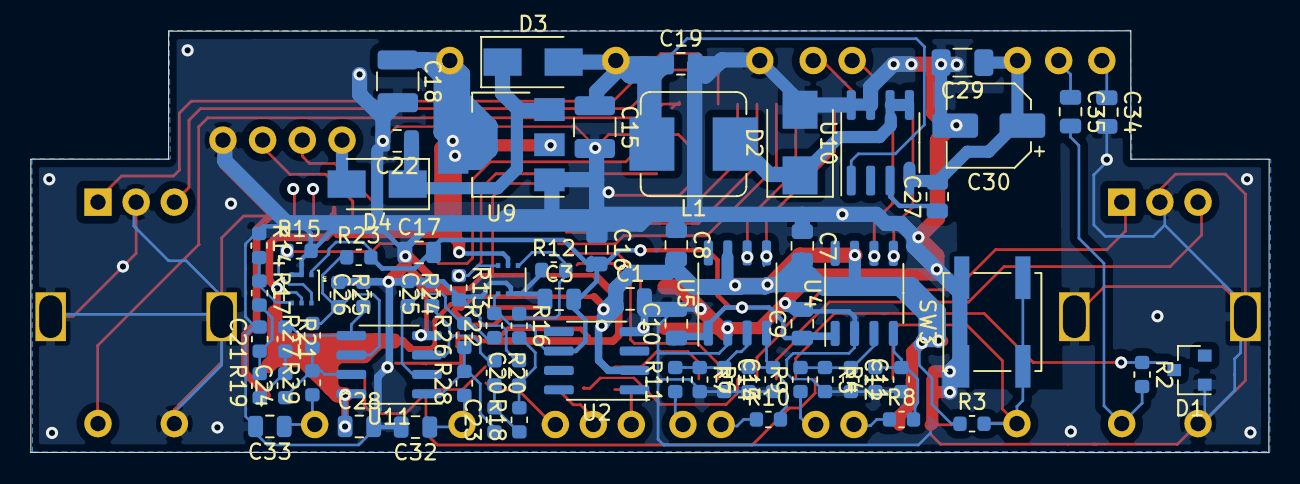
[picture p49: board esp2400.kicad_pcb from below]

Board: 2 copper layers, 81.1 x 27.6 mm, 110 parts (72 on the bottom side), 63 nets.
