m24h/esp2400/hardware/fan.kicad_pcb

## KiCad design hardware/fan.kicad_pcb (2022-01-13)

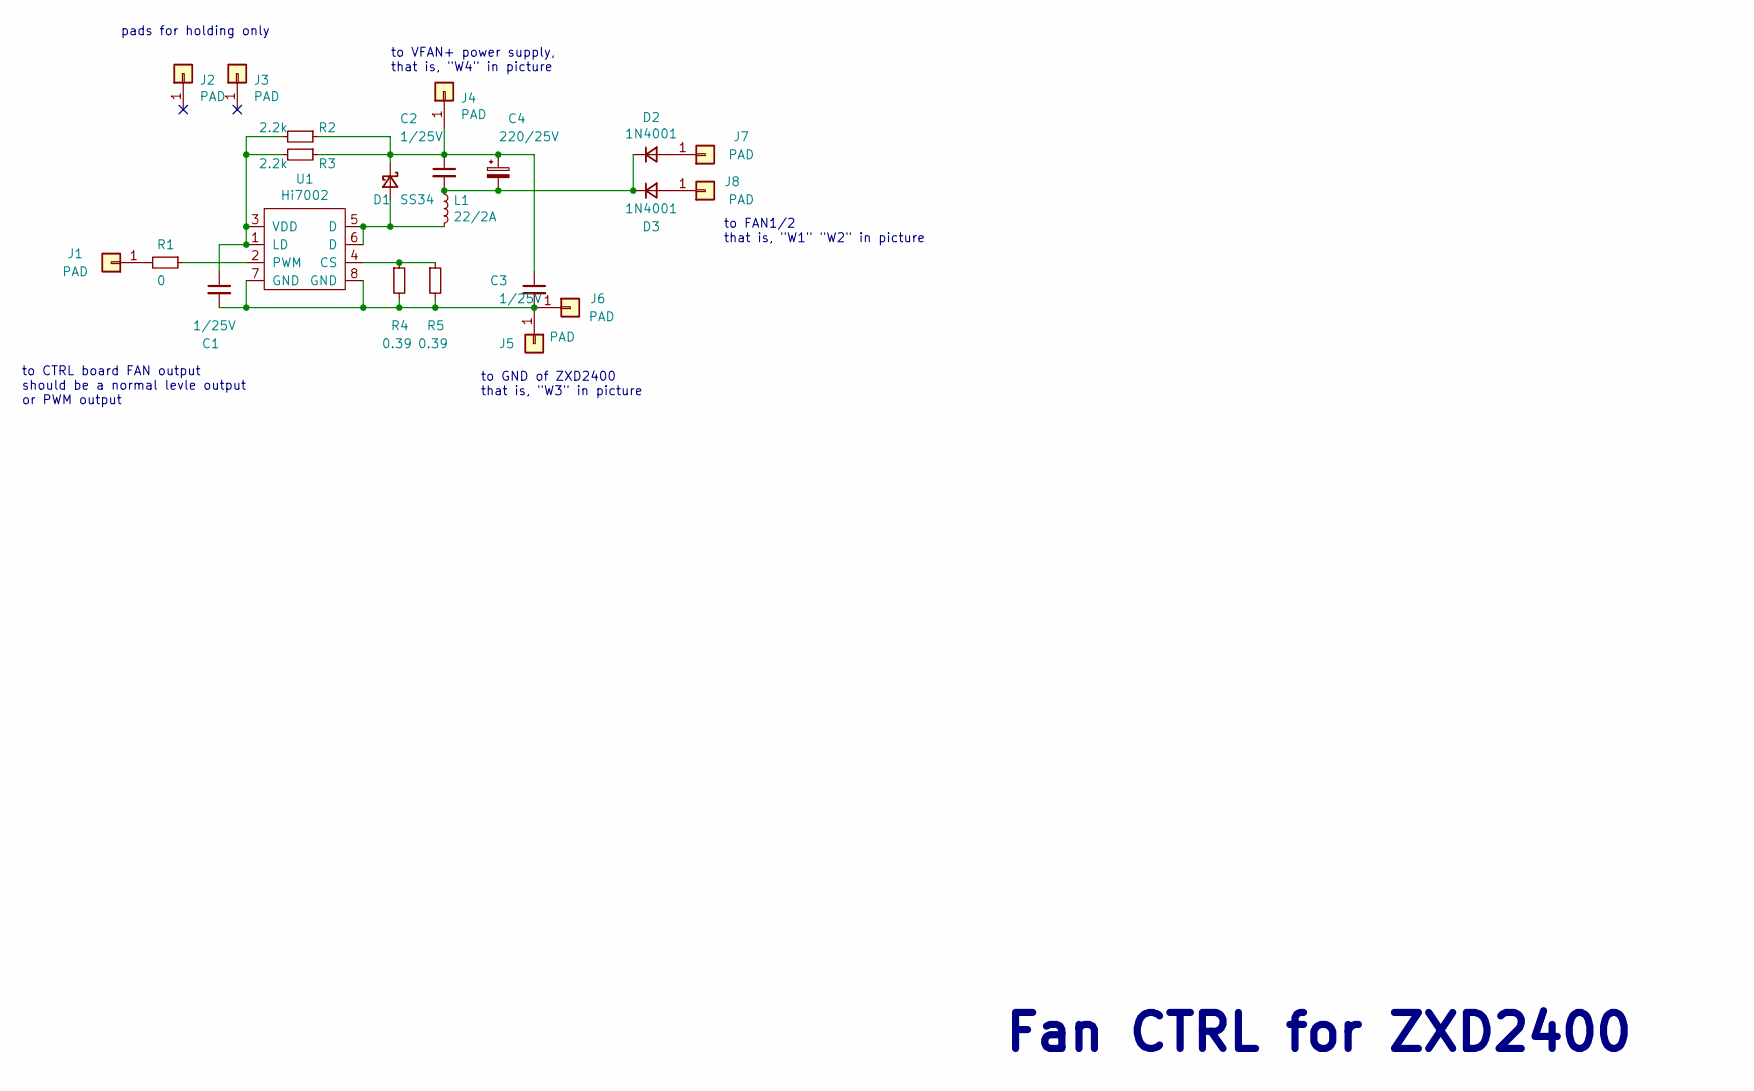
[picture p50: schematic fan.sch]

Parts:
C1, C2, C3: 1/25V; C_0805_2012Metric
C4: 220/25V; CP_Radial_D6.3mm_P2.50mm
D1: SS34; D_SMB
D2, D3: 1N4001; D_DO-41_SOD81_P7.62mm_Horizontal
J1, J2, J3, J4, J5, J6, J7, J8: PAD; Pad-big
L1: 22/2A; L_Bourns_SRP7028A_7.3x6.6mm
R1: 0; R_0805_2012Metric
R2, R3: 2.2k; R_0805_2012Metric
R4, R5: 0.39; R_1206_3216Metric
U1: Hi7002; SOP-8_3.9x4.9mm_P1.27mm

Connections:
unnamed: C1.1, R2.2, R3.2, U1.1 (LD), U1.3 (VDD)
unnamed: C1.2, C3.2, J5.1, J6.1, R4.2, R5.2, U1.7 (GND), U1.8 (GND)
unnamed: C2.1, C3.1, C4.1, D1.1 (K), J4.1, R2.1, R3.1
unnamed: C2.2, C4.2, D2.1 (K), D3.1 (K), L1.1
unnamed: D1.2 (A), L1.2, U1.5 (D), U1.6 (D)
unnamed: D2.2 (A), J7.1
unnamed: D3.2 (A), J8.1
unnamed: J1.1, R1.2
unnamed: R1.1, U1.2 (PWM)
unnamed: R4.1, R5.1, U1.4 (CS)

Notes on the sheet:
Fan CTRL for ZXD2400
to GND of ZXD2400 that is, "W3" in picture
to FAN1/2 that is, "W1" "W2" in picture
to CTRL board FAN output should be a normal levle output or PWM output
pads for holding only
to VFAN+ power supply, that is, "W4" in picture

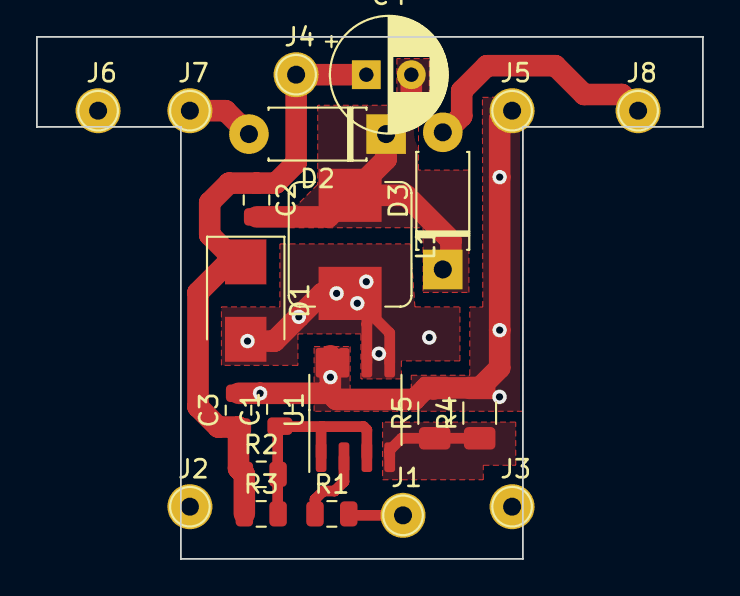
[picture p51: board fan.kicad_pcb from above]

Board: 2 copper layers, 37.0 x 29.0 mm, 22 parts (0 on the bottom side), 10 nets.
